matarga/vipr/KiCAD/main/viper.png

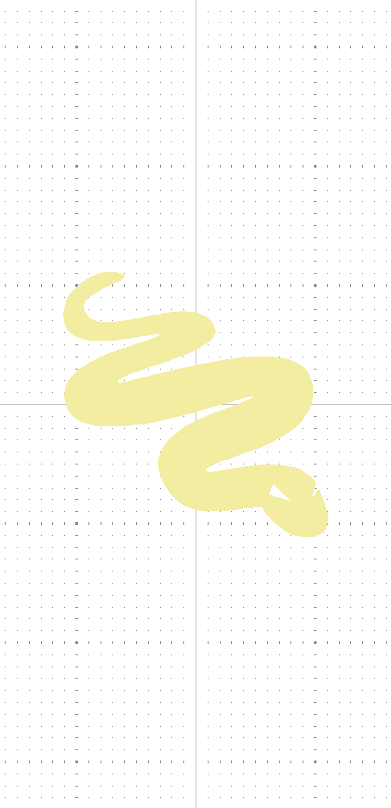
KiCAD/main/viper.png
