matarga/vipr/KiCAD/ref/SX1262 mbed shield with Murata IPD/SX1262MB2IPDDAS_868-915MHz_e588v01a_Murata_BOM.xlsx

Sheet: SX1262MB2IPDDAS
 |  |  | SX1262MB2IPDDAS mbed shield with IPD filter BOM - 868/915MHz |  |  | BOM # V1a
 |  |  |  |  |  | SCH # e588v01a
 |  |  | 2025-11-11 | EMr | Version e588v01a | PCB # e588v01a
RefDes | MPN | Geom | Value | Qty | Description | Manufacturer
U1 | SX1262IMLTRT | VQFN24 4x4mm | SX1262 | 1 | 150MHz to 960MHz Low Power Long Range Transceiver | Semtech
U2 | BGS12WN6 | PG-TSNP-6-10 | - | 1 | Wideband SPDT Diversity Switch with Fast Switching Speed | Infineon
U3 | LFB21892MDZ7F957 | 2.00x1.25mm | 868/915MHz | 1 | 868/915MHz Miniature Impedance-matched Filter for SX1261/62 and LLCC68 optimized for US and EU +22 dBm Operation | Murata
Resistors
R1 | CRCW06030000Z0EAHP | 0603 | 0R | 1 | Thick Film Resistor ±1%, 1/4W | Vishay/Dale
R2 | CRCW06030000Z0EAHP | 0603 | 0R | 1 | Thick Film Resistor ±1%, 1/4W | Vishay/Dale
R3 | CRCW0201100RJNED | 0201 | 100R | 1 | Thick Film Resistor ±5%, 1/20W | Vishay/Dale
R4 | CRCW0201100RJNED | 0201 | 100R | 1 | Thick Film Resistor ±5%, 1/20W | Vishay/Dale
R5 | CRCW02013K30JNED | 0201 | 3.3k | 1 | Thick Film Resistor ±5%, 1/20W | Vishay/Dale
R6 | CRCW02013K30JNED | 0201 | 3.3k | 1 | Thick Film Resistor ±5%, 1/20W | Vishay/Dale
R18 | CRCW04020000Z0ED | 0402 | 0R | 1 | Thick Film Resistor ±1%, 1/16W | Vishay/Dale
R868 | CRCW04020000Z0ED | 0402 | 0R | 1 | Thick Film Resistor ±1%, 1/16W | Vishay/Dale
R915 | CRCW04020000Z0ED | 0402 | 0R | 1 | Thick Film Resistor ±1%, 1/16W | Vishay/Dale
SX1262 | CRCW040210K0FKED | 0402 | 10k | 1 | Thick Film Resistor ±1%, 1/16W | Vishay/Dale
FR1 | CRCW040210K0FKED | 0402 | 10k | 1 | Thick Film Resistor ±1%, 1/16W | Vishay/Dale
XTAL | CRCW04020000Z0ED | 0402 | 0R | 1 | Thick Film Resistor ±1%, 1/16W | Vishay/Dale
Capacitors
C1 | GRM033R61C473KE84D | 0201 | 47nF | 1 | Multilayer ceramic capacitors X5R ±10%, 16V | Murata
C2 | GRM0335C1H470JA01D | 0201 | 47pF | 1 | Multilayer ceramic capacitors COG ±5%, 50V | Murata
C8 | GRM0335C1H390JA01D | 0201 | 39pF | 1 | Multilayer ceramic capacitors COG ±5%, 50V | Murata
C9 |  | 0201 | NC | 0 |  | Murata
C10 |  | 0201 | NC | 0 |  | Murata
C14 | GRM033R71H102KA12D | 0201 | 1nF | 1 | Multilayer ceramic capacitors X7R ±10%, 50V | Murata
C15 | GRM033R71H102KA12D | 0201 | 1nF | 1 | Multilayer ceramic capacitors X7R ±10%, 50V | Murata
C16 | GRM155R61E105KA12D | 0402 | 1uF | 1 | Multilayer ceramic capacitors X5R ±10%, 10V | Murata
C17 | GRM155R61A474KE15D | 0402 | 470nF | 1 | Multilayer ceramic capacitors X5R ±10%, 10V | Murata
C18 | GRM033R61A104KE15D | 0201 | 100nF | 1 | Multilayer ceramic capacitors X5R ±10%, 10V | Murata
C20 | GRM188R61A105KA61D | 0603 | 1uF | 1 | Multilayer ceramic capacitors X5R ±10%, 10V | Murata
C21 | GRM188R61A105KA61D | 0603 | 1uF | 1 | Multilayer ceramic capacitors X5R ±10%, 10V | Murata
C22 | GRM188R61A106KE69D | 0603 | 10uF | 1 | Multilayer ceramic capacitors X5R ±10%, 10V | Murata
C23 | GRM033R61A104KE15D | 0201 | 100nF | 1 | Multilayer ceramic capacitors X5R ±10%, 10V | Murata
Inductors & Ferrites
L1 | LQW15AN47NJ00D | 0402 | 47nH | 1 | Wirewound Inductor ±5% | Murata
L5 | CRCW02010000Z0ED | 0201 | 0R | 1 | Thick Film Resistor ±5%, 1/20W | Murata
L7 | MLZ2012M150W | 0805 | 15uH | 1 | MLZ2012 Multilayer Shielded Inductor ±5% | TDK
or (2nd source) | MLZ1608N100LT000 | 0603 | 10uH | 1 | MLZ1608 Multilayer Shielded Inductor ±20% | TDK
or (2nd source) | MLZ1608N150LT000 | 0603 | 15uH | 1 | MLZ1608 Multilayer Shielded Inductor ±20% | TDK
L8 |  | 0402 | 47nH | 0 |  | Murata
Crystal & TCXO
Q1 | EXS00A-CS06465 | NX2016SA 2.0x1.6mm | 32.000MHz | 1 | Crystal unit NDK; Tol. ±10ppm, Cload=10pF, G-Senstivity=2ppb/G max | NDK
or | FTR5123-A0 | QESM09 2.0x1.6mm | 32.000MHz | - | Crystal unit Rakon; Tol. ±10ppm, Cload=10pF, G-Senstivity=2ppb/G max | Rakon
Connectors and others (or P/N equivalent)
ANT | 142-0701-841 | SMA End Launch | 50 Ohms | 1 | SMA End launch jack receptacle for PCB mount for 1.00mm PCB thickness | Cinch Connectivity Sol Johnson
J1 | 68000-108HLF | Header 1x8 | 8 pins | 1 | 8 Pins - Through hole single row male connector, Bottom side | FCI
J2 | 68000-110HLF | Header 1x10 | 10 pins | 1 | 10 Pins - Through hole single row male connector, Bottom side | FCI
J3 | 68000-108HLF | Header 1x8 | 8 pins | 1 | 8 Pins - Through hole single row male connector, Bottom side | FCI
J4 | 68000-106HLF | Header 1x6 | 6 pins | 1 | 6 Pins - Through hole single row male connector, Bottom side | FCI
ANA_A5_A6 | 1125S-4P | 4-pin - Grove | 4 pins | 0 | 2mm pitch - Grove universal 4-pin connector for sensor (SKU: 320110033), Top side | Shenzhen NS-Tech
DIO_D9_D10 | 1125S-4P | 4-pin - Grove | 4 pins | 0 | 2mm pitch - Grove universal 4-pin connector for sensor (SKU: 320110033), Top side | Shenzhen NS-Tech
I2C | 1125S-4P | 4-pin - Grove | 4 pins | 0 | 2mm pitch - Grove universal 4-pin connector for sensor (SKU: 320110033), Top side | Shenzhen NS-Tech
Additional or optional components
- | BMI-S-209-F | Shield | - | 0 | Standard Surface Mount Shield in two parts with BMI-S-209-C cover (optional) | Laird Technologies
Remark: components not listed in the BOM or 0 quantity, are not populated on the module.

Sheet: Release
 |  | SX1262MB2IPDDAS mbed shield with IPD filter BOM - 868/915MHz |  |  |  | BOM # V1a
 |  |  |  |  |  | SCH # e588v01a
 |  | 2025-11-11 | EMr | Version e588v01a |  | PCB # e588v01a
Release history
Version | Change notes |  |  |  | By
pcb_e588v01a | Module based on PCB_E499V01B with IPD filter. |  |  |  | EMr
 | Update BOM with P/N - 18.05.2020 |  |  |  | EMr
 | Update BOM @868/915MHz only with P/N - 22.02.2022 |  |  |  | EMr
 | Replacement of U2 RF switch with BGS12WN6 - 03.03.2025 |  |  |  | EMr
 | IPD Murata P/N updated |  |  |  | EMr
