matarga/vipr/KiCAD/main/step/901-10040-1/3D/901-10040-1.stp

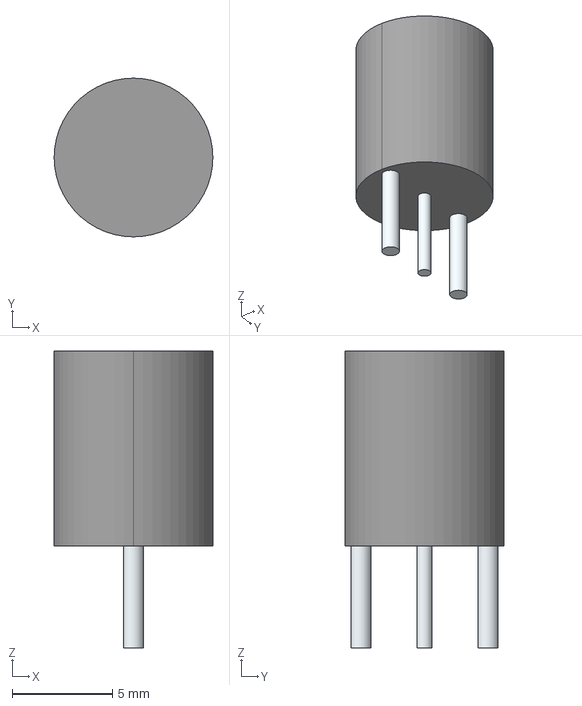
[picture p5: CAD file, 2026-09-06]
KiCAD/main/step/901-10040-1/3D/901-10040-1.stp
7.92 x 7.92 x 14.8 mm
Leads x 3
