matarga/vipr/KiCAD/main/step/FT231XQ-R/3D/FT231XQ-R.stp

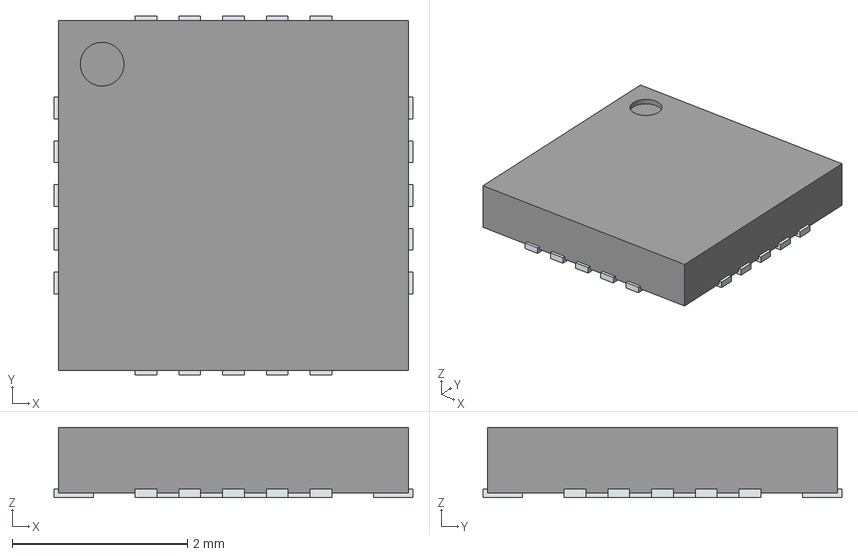
[picture p6: CAD file, 2026-09-06]
KiCAD/main/step/FT231XQ-R/3D/FT231XQ-R.stp
4.10 x 4.10 x 0.8 mm
ThermalPin
PinsArrayLR
PinsArrayTB
