matarga/vipr/KiCAD/main/step/TP4056-42-ESOP8/3D/TP4056-42-ESOP8.stp

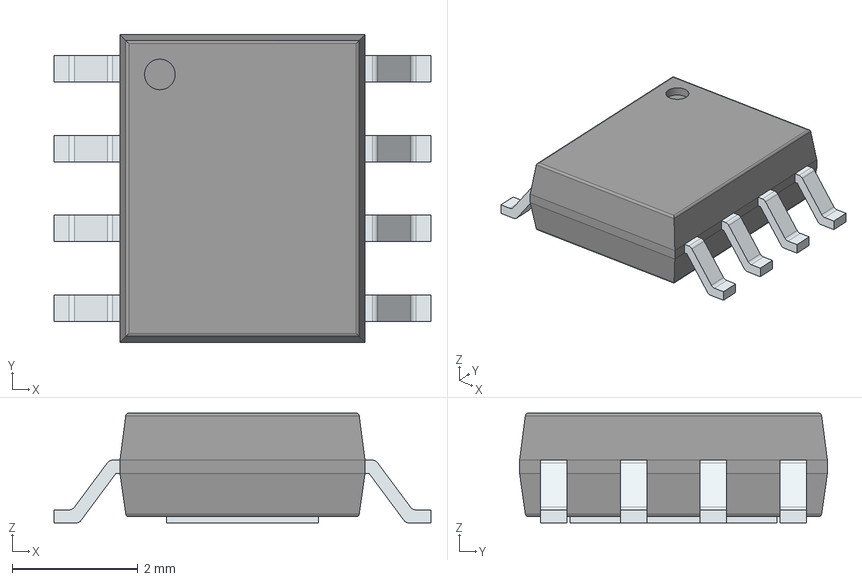
[picture p7: CAD file, 2026-09-06]
KiCAD/main/step/TP4056-42-ESOP8/3D/TP4056-42-ESOP8.stp
6.00 x 4.90 x 1.75 mm
PinsArrayLR
ThermalPad
