matarga/vipr/KiCAD/main/finals/rev 2.0/main.step

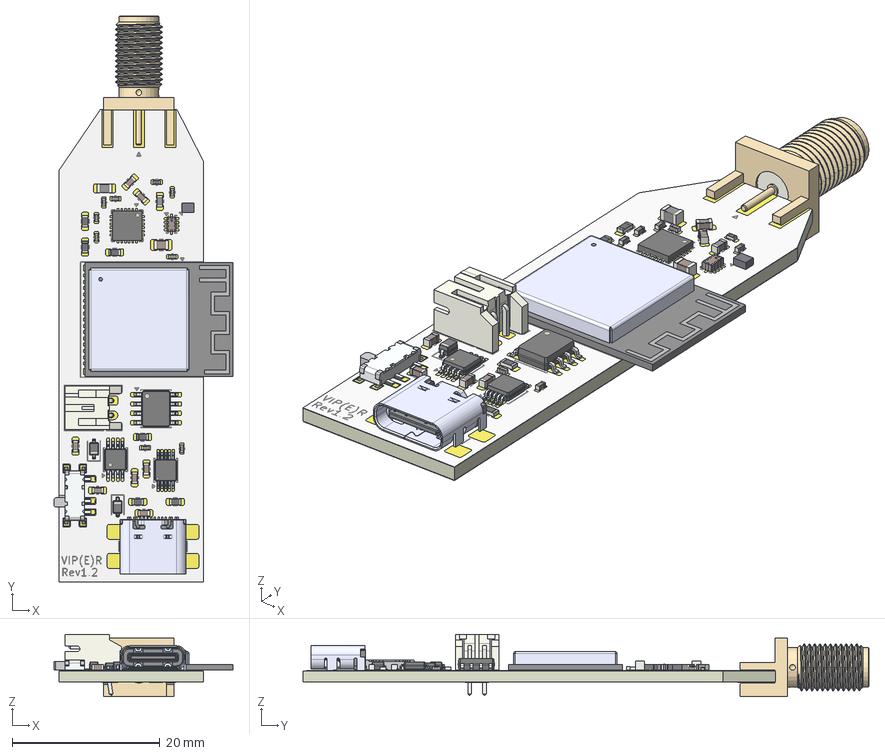
[picture p8: CAD file, 2026-09-06, an earlier design]
KiCAD/main/finals/rev 2.0/main.step
24.2 x 76.6 x 8.43 mm
C_0603_1608Metric x 7
C_0402_1005Metric x 8
R_0603_1608Metric x 6
ESP32-S2-MINI-1
QFN-24-1EP_4x4mm_Pitch0.5mm
D_SOD-323 x 2
MSOP-8_3x3mm_P0.65mm
L_0805_2012Metric
X-axis x 3
XY-plane x 3
Sketch
Sketch001
LinearPattern
SOIC-8-1EP_3.9x4.9mm_P1.27mm_EP2.41x3.81mm
SMA_Amphenol_132289_EdgeMount
SSSS810701
USB4105GFA_USB4105GFA
JST_S2B_PH_K
4d195fed-b8b3-11ee-a4d2-001e64e93a09_part
4d195fee-b8b3-11ee-a4d2-001e64e93a09_part
4d195fef-b8b3-11ee-a4d2-001e64e93a09_part
C_0805_2012Metric
R_0402_1005Metric
MSOP-10_3x3mm_P0.5mm
L_0603_1608Metric
main-unsaved-export-qwL5oJ_copper
main-unsaved-export-qwL5oJ_silkscreen x 2
main-unsaved-export-qwL5oJ_soldermask x 2
main-unsaved-export-qwL5oJ_PCB
