matarga/vipr/(list of files, cad)

Other CAD files:
KiCAD/main/step/901-10040-1/Allegro/901100401.psm
KiCAD/main/step/901-10040-1/DEHDL/901_10040_1/chips/chips.prt
KiCAD/main/step/BGS12WN6E6327XTSA1/Allegro/bgs12wn6e6327xtsa1.psm
KiCAD/main/step/BGS12WN6E6327XTSA1/DEHDL/bgs12wn6e6327xtsa1/chips/chips.prt
KiCAD/main/step/ESP32-MINI-1-H4/Allegro/esp32mini1h4.psm
KiCAD/main/step/ESP32-MINI-1-H4/DEHDL/esp32_mini_1_h4/chips/chips.prt
KiCAD/main/step/FT231XQ-R/Allegro/qfn50p400x400x80-21n.psm
KiCAD/main/step/FT231XQ-R/DEHDL/ft231xq_r/chips/chips.prt
KiCAD/main/step/SX1262IMLTRT/Allegro/qfn50p400x400x100-25n-d.psm
KiCAD/main/step/SX1262IMLTRT/DEHDL/sx1262imltrt/chips/chips.prt
KiCAD/main/step/TLV75533PDRVR/Allegro/son65p200x200x80-7n.psm
KiCAD/main/step/TLV75533PDRVR/DEHDL/tlv75533pdrvr/chips/chips.prt
KiCAD/main/step/TP4056-42-ESOP8/DEHDL/tp4056_42_esop8/chips/chips.prt
