matarga/vipr/KiCAD/ref/SX1262 mbed shield with Murata IPD/SX1262MB2IPDDAS_e588v01a_Murata_IPD_schematic_layout.pdf

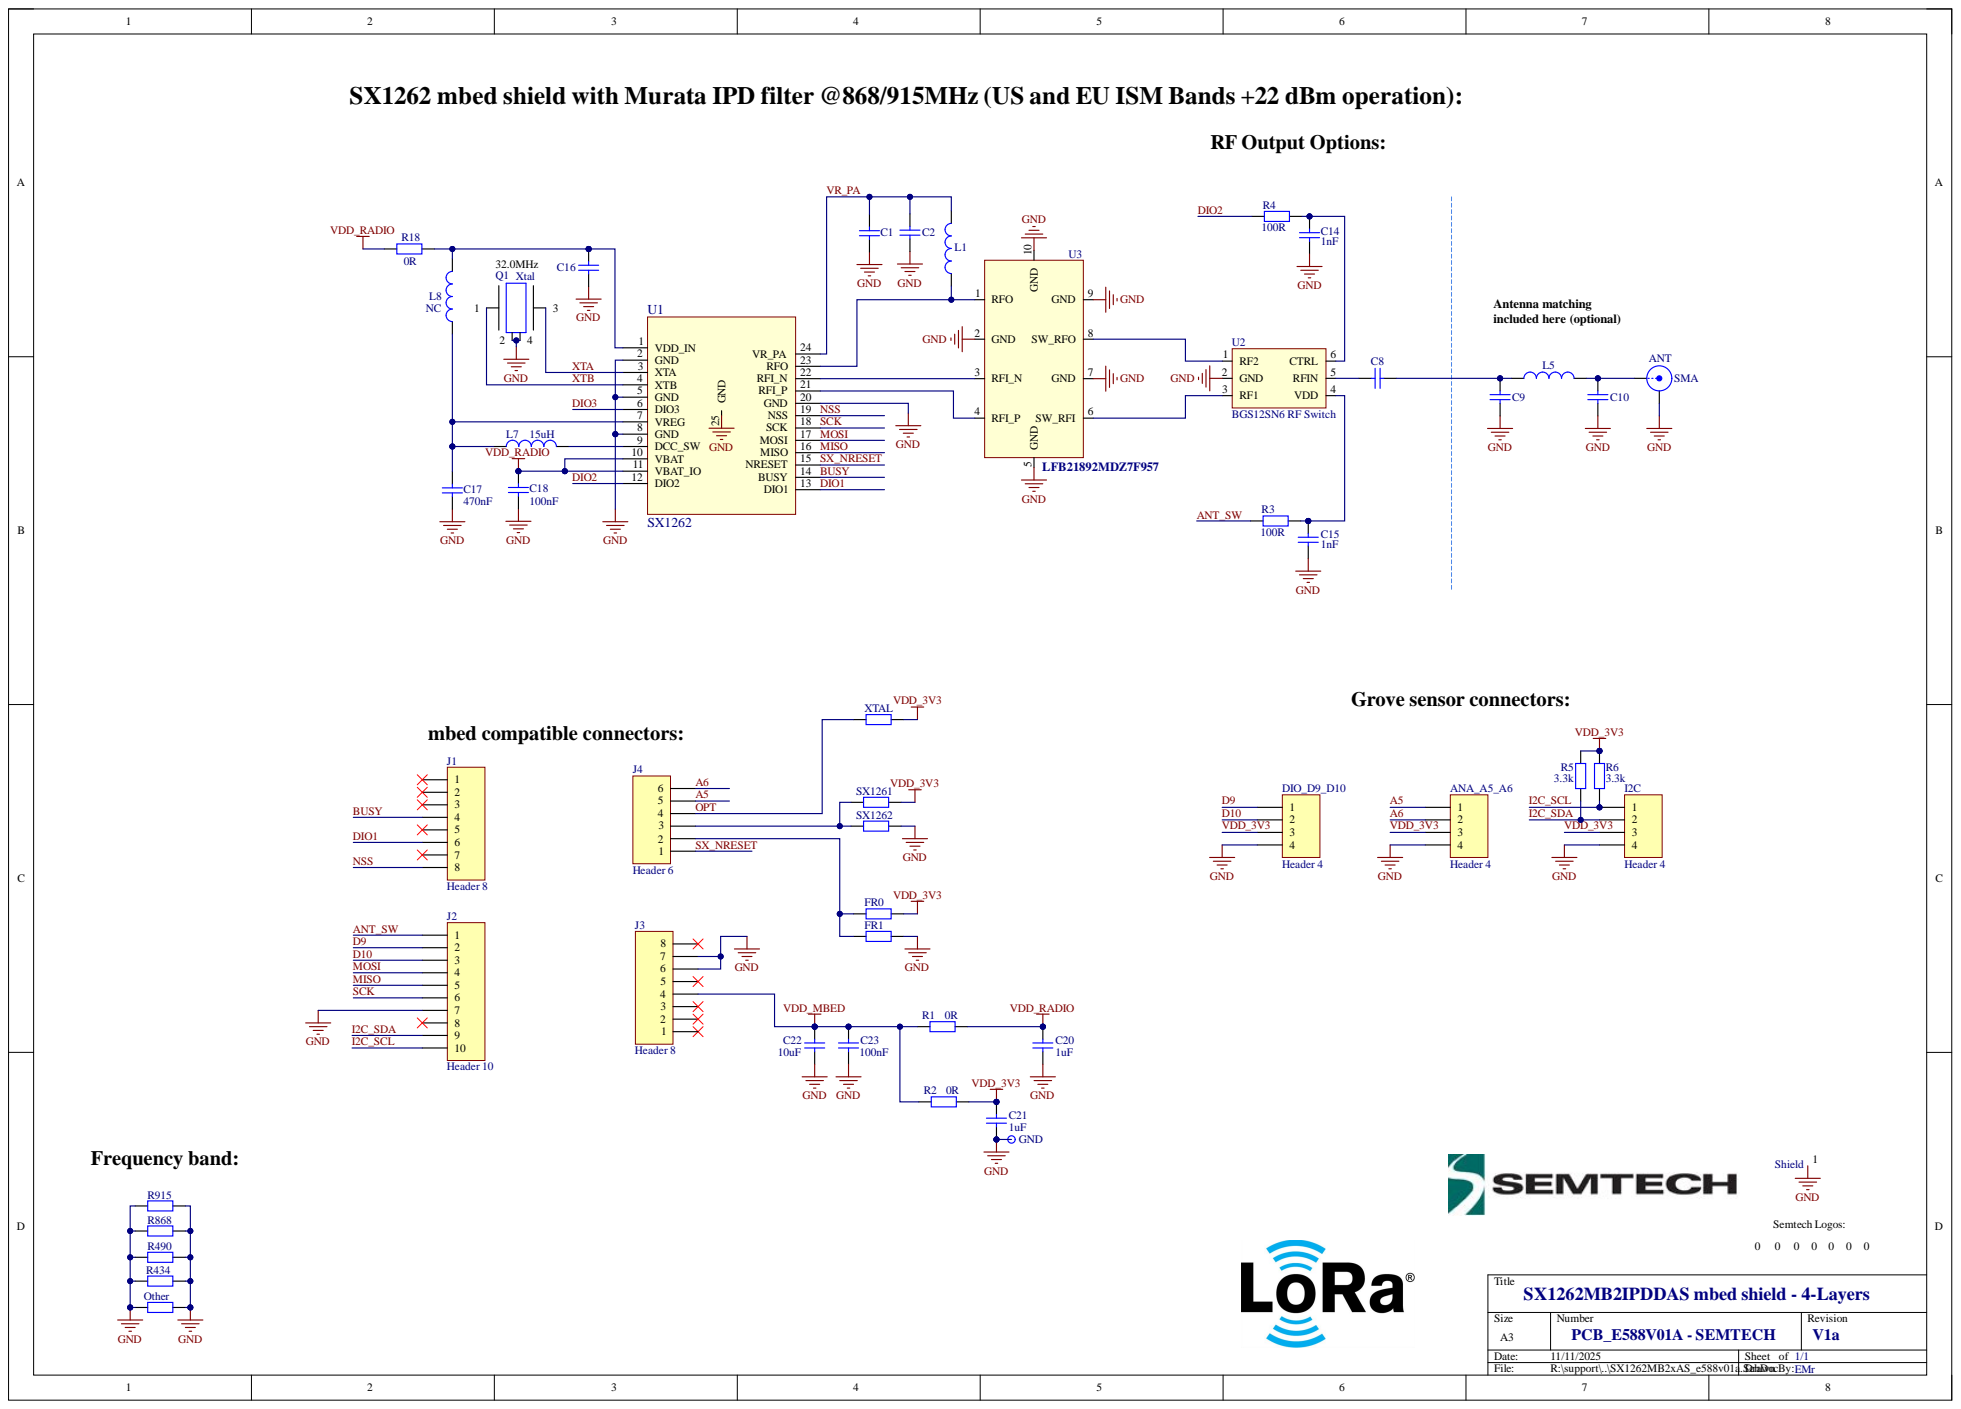
[picture p12: page 1]

SX1262 mbed shield with Murata IPD filter @868/915MHz (US and EU ISM Bands +22 dBm operation):

GND

DIO2 12 | BUSY

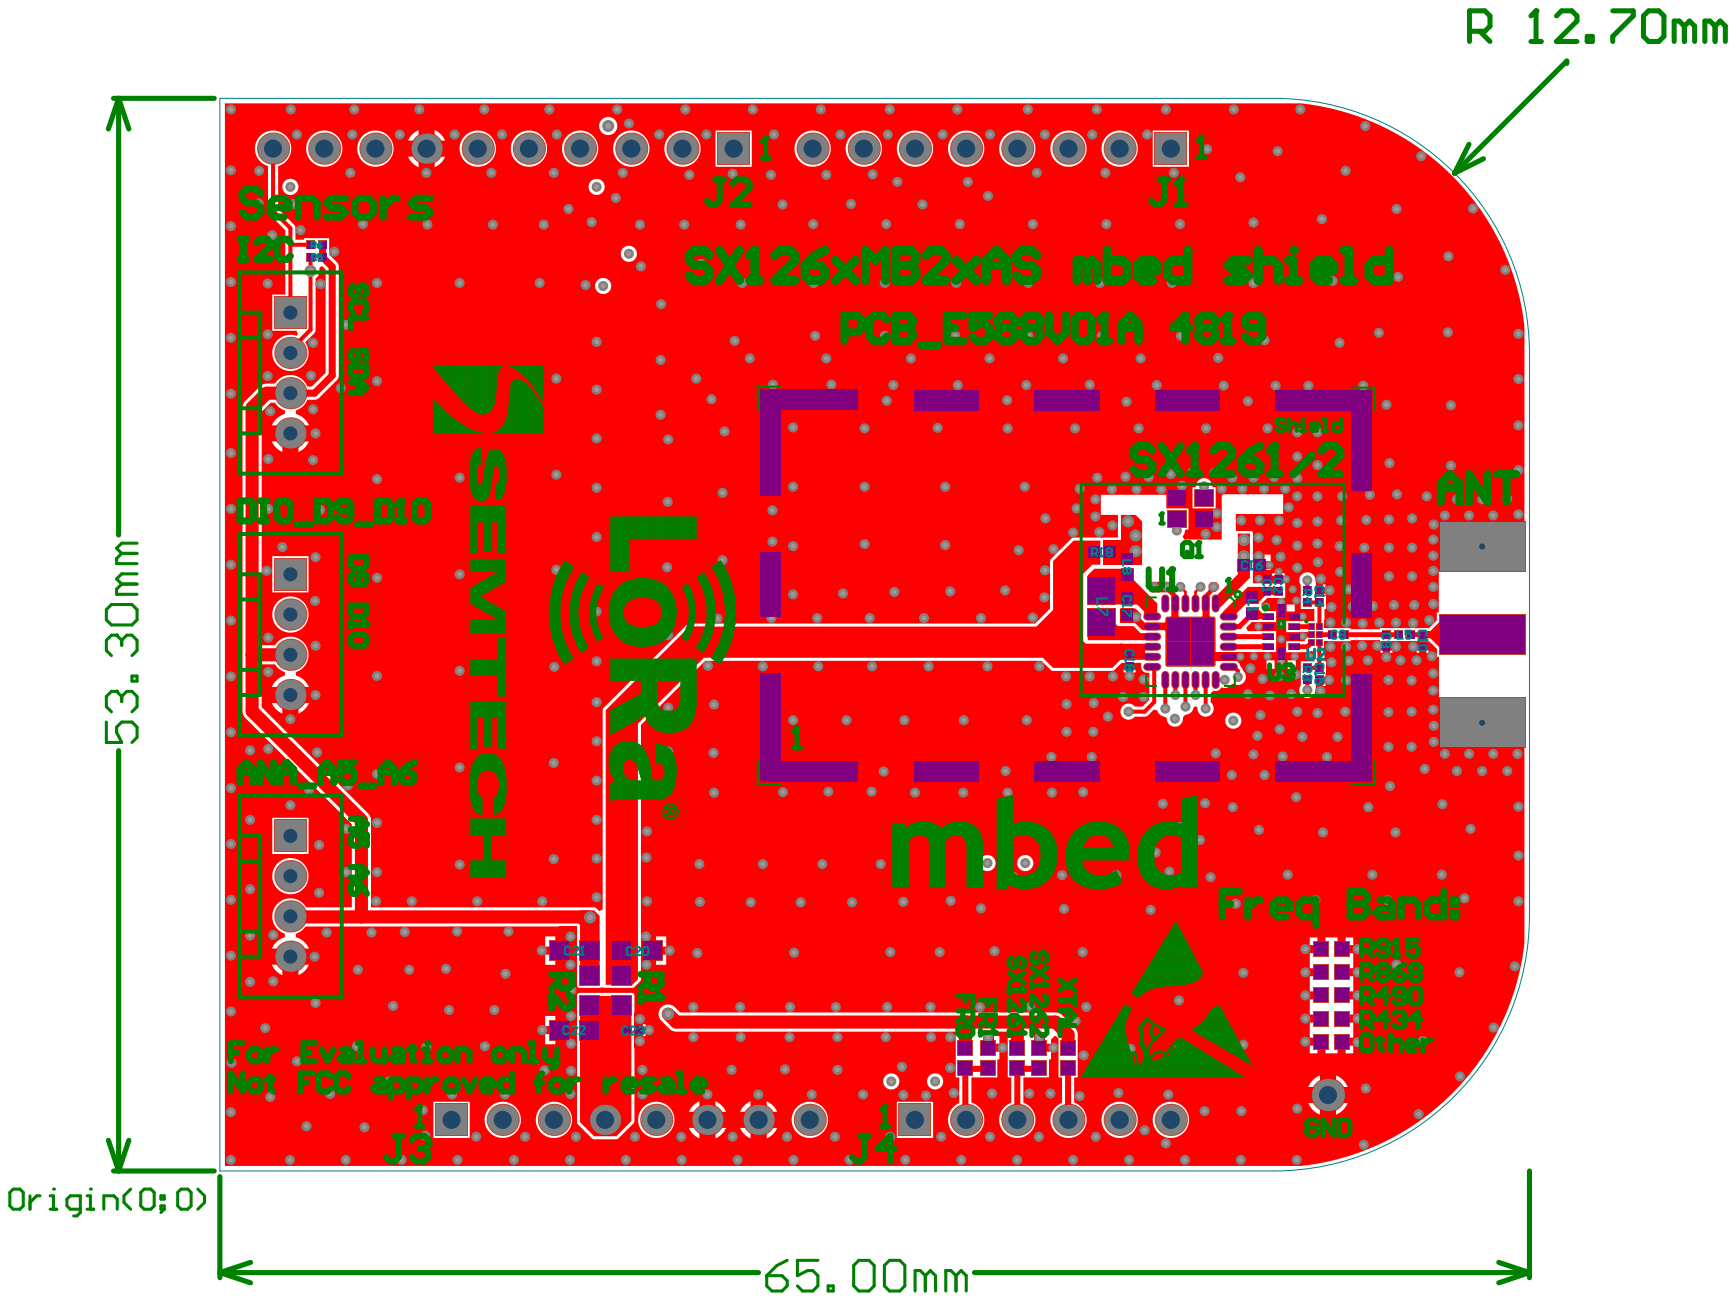
[picture p13: page 2]

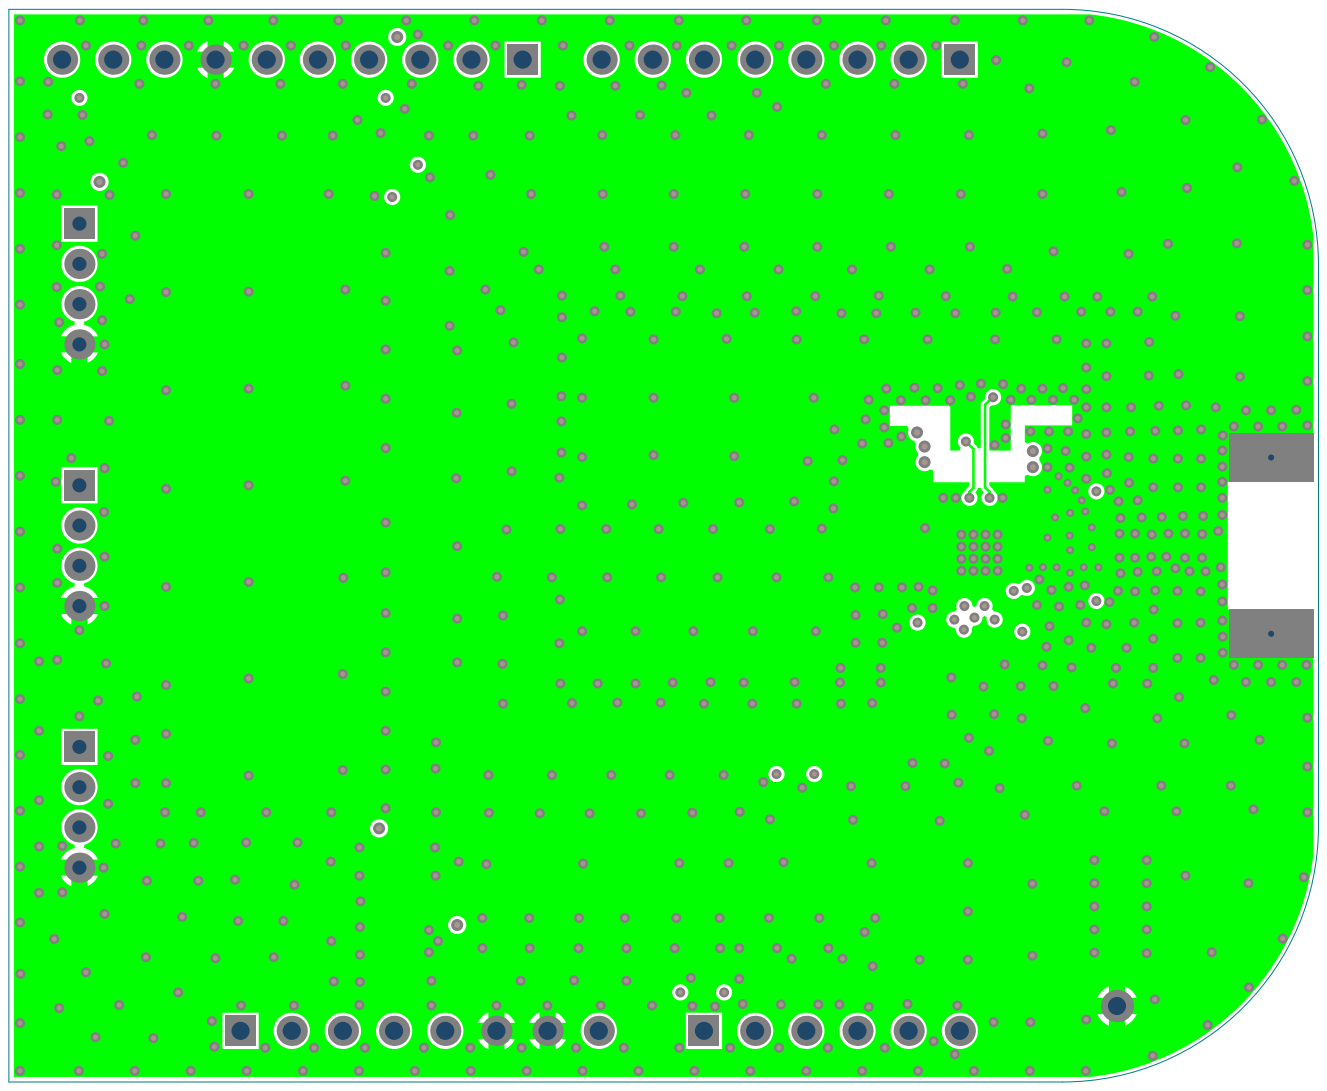
[picture p14: page 3]

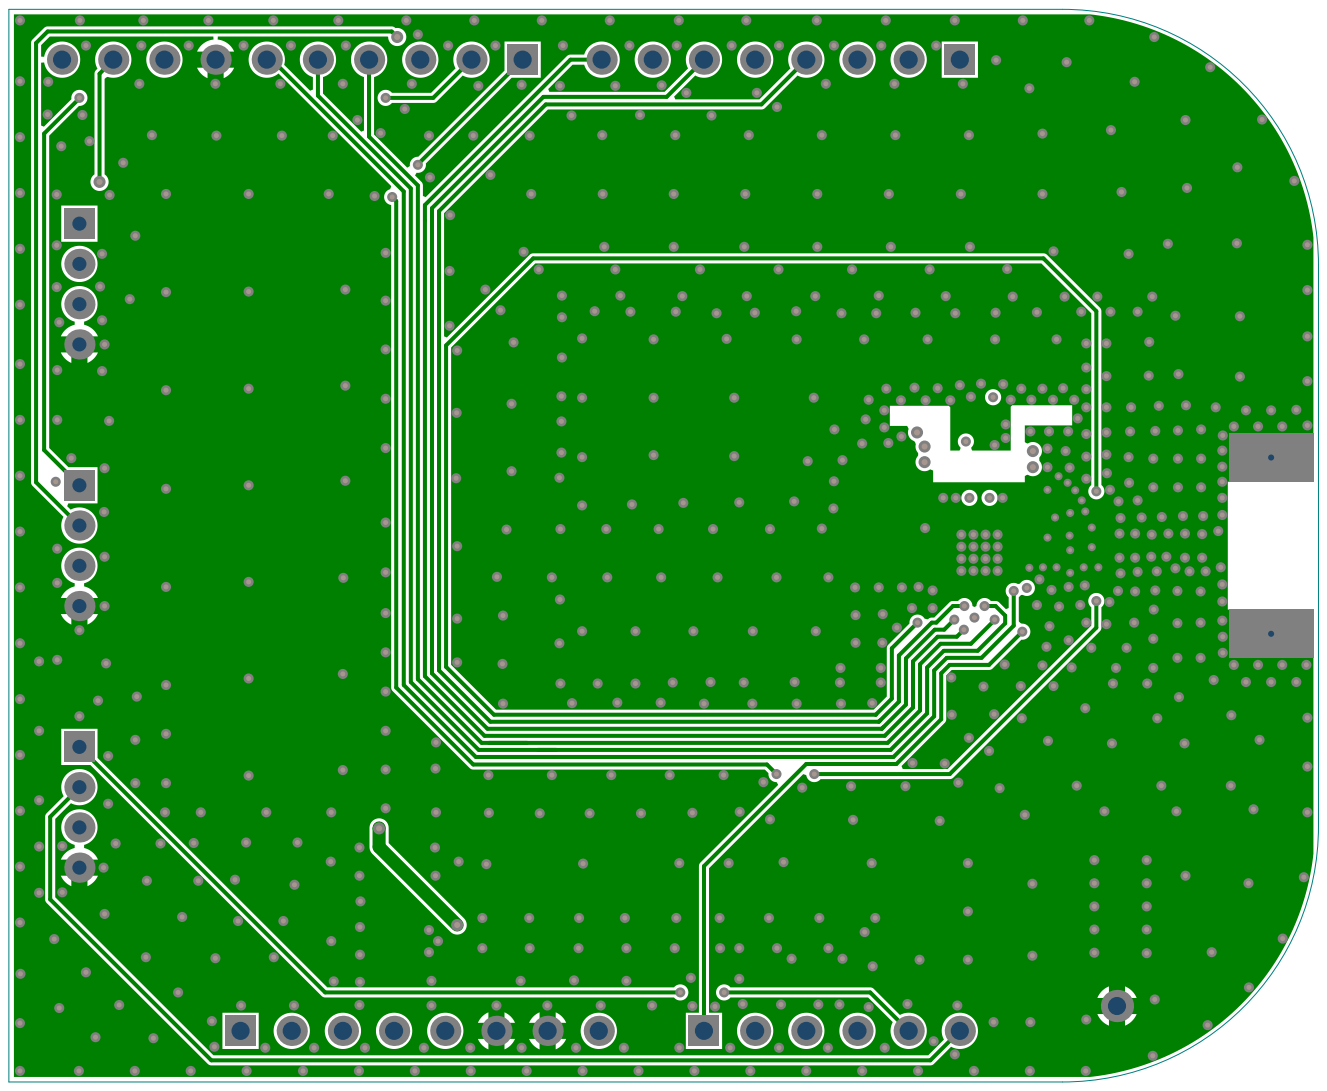
[picture p15: page 4]

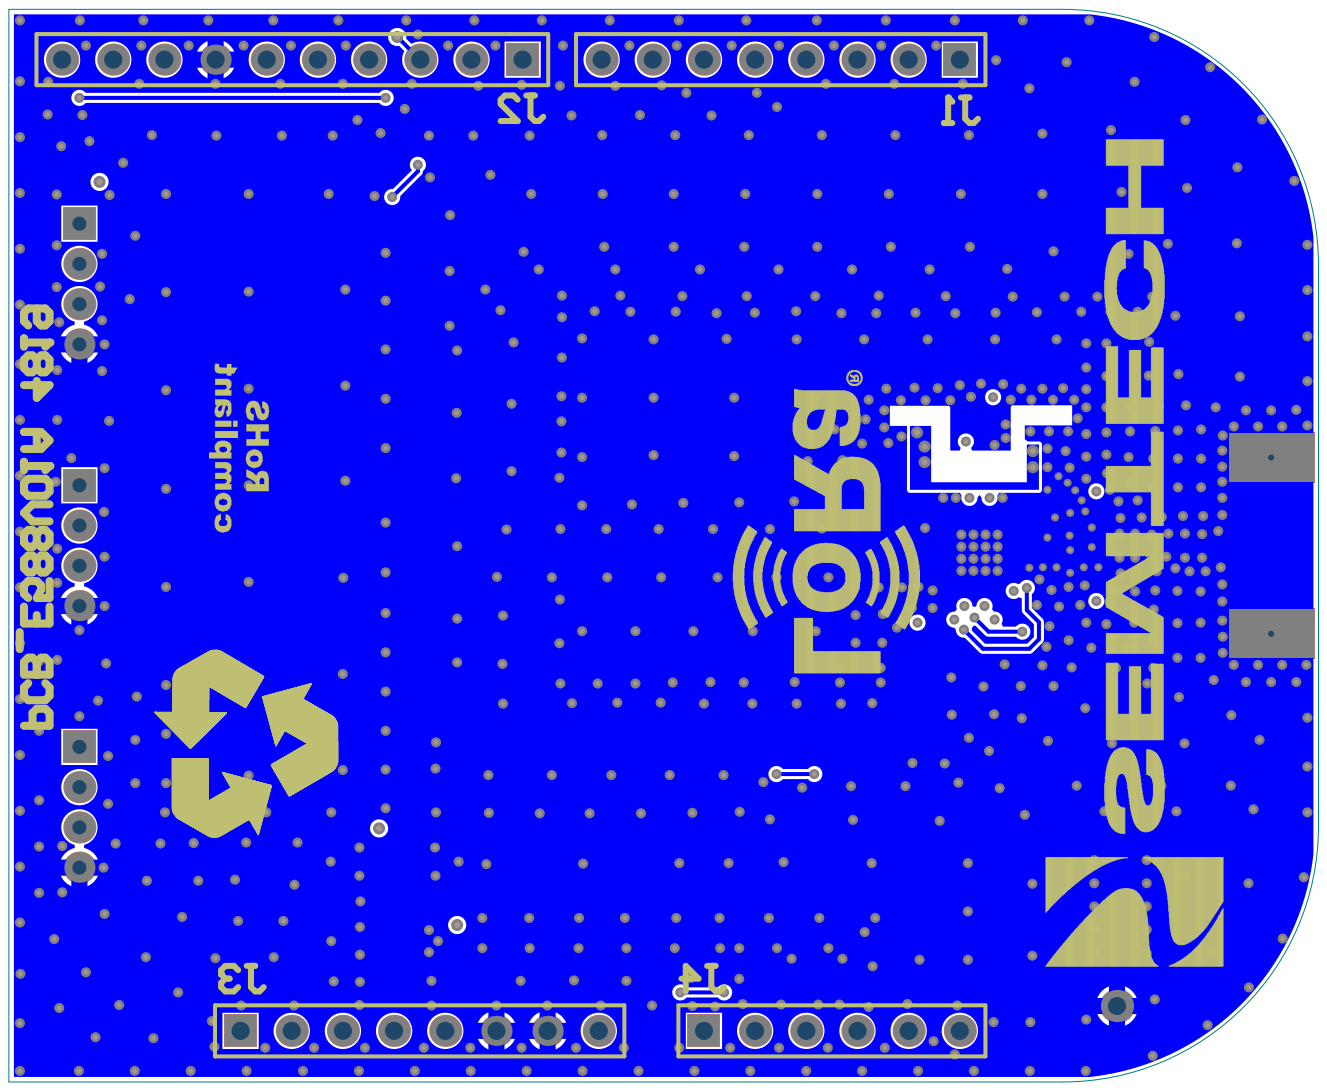
[picture p16: page 5]
