matarga/vipr/KiCAD/ref/SX1262 mbed shield with Murata IPD/SX126xMB2IPDDAS_868-915MHz_e588v01a_assembly.pdf

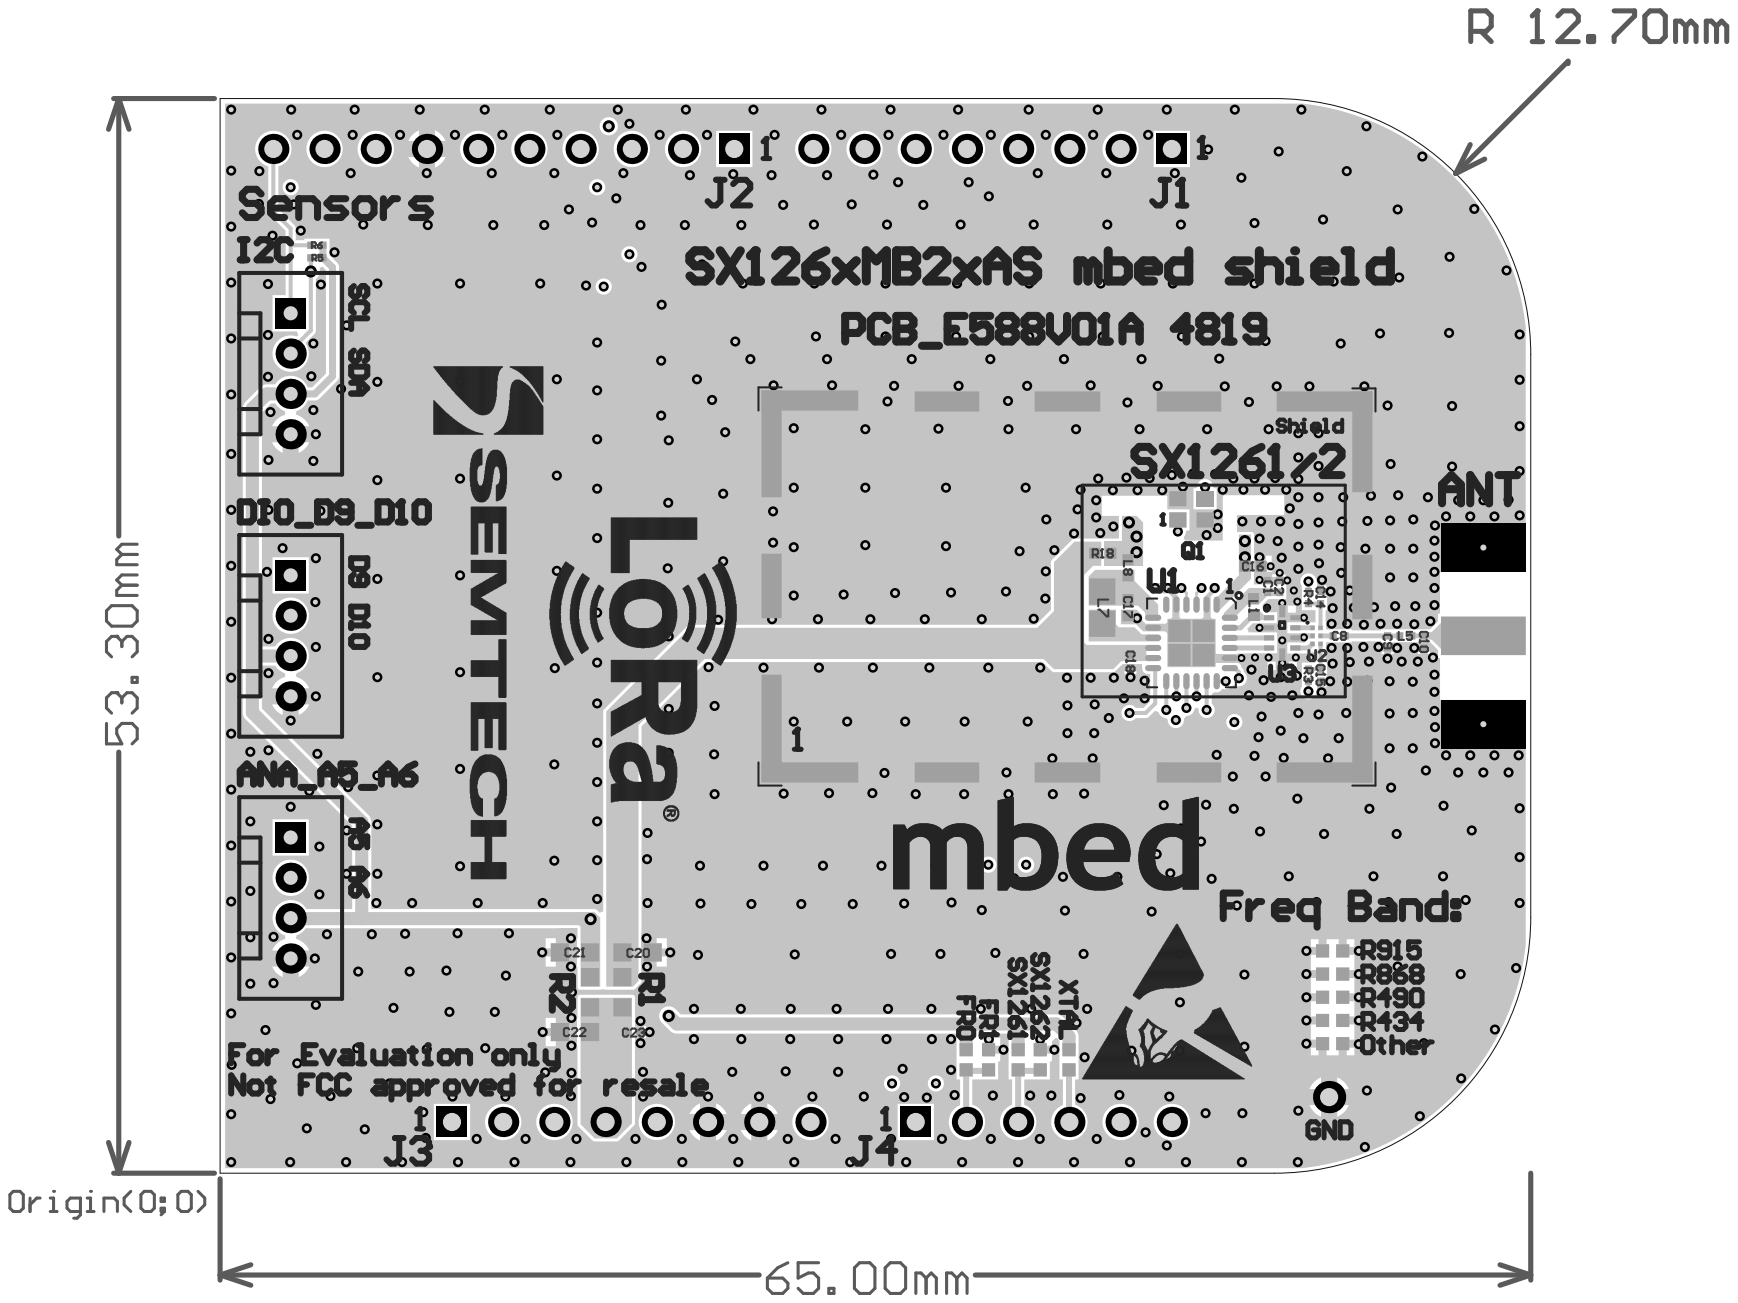
[picture p17: page 1]

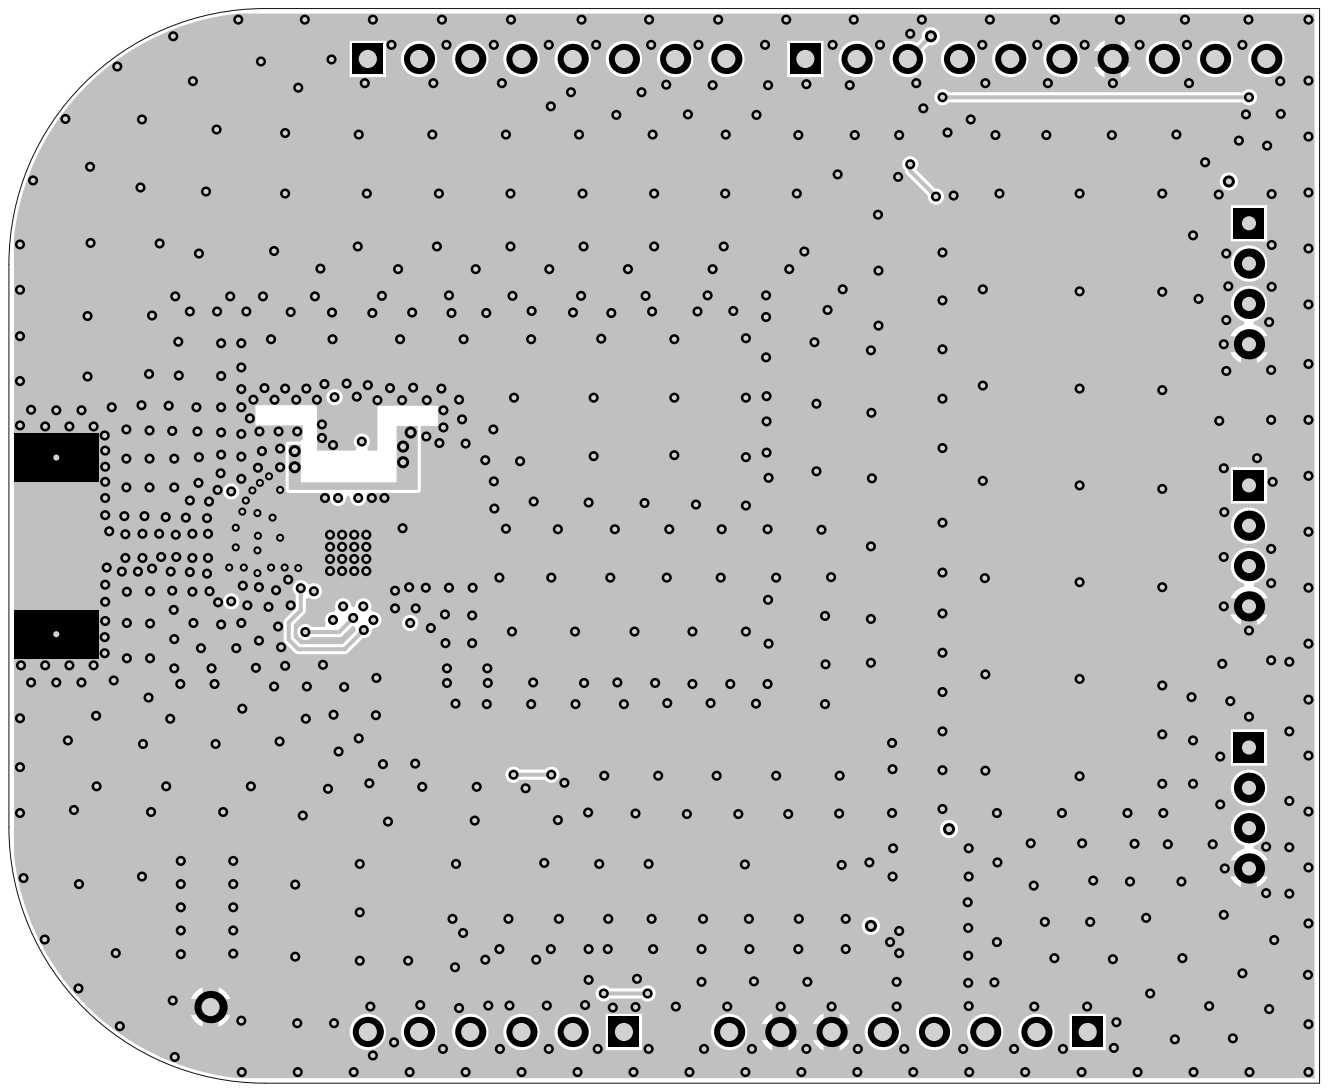
[picture p18: page 2]
