matarga/vipr/(list of files, drawings)

Other design files:
KiCAD/main/step/901-10040-1/Altium/901-10040-1.SchLib
KiCAD/main/step/901-10040-1/Altium/901100401.PcbLib
KiCAD/main/step/BGS12WN6E6327XTSA1/Altium/BGS12WN6E6327XTSA1.PcbLib
KiCAD/main/step/BGS12WN6E6327XTSA1/Altium/BGS12WN6E6327XTSA1.SchLib
KiCAD/main/step/ESP32-MINI-1-H4/Altium/ESP32-MINI-1-H4.SchLib
KiCAD/main/step/ESP32-MINI-1-H4/Altium/ESP32MINI1H4.PcbLib
KiCAD/main/step/FT231XQ-R/Altium/FT231XQ-R.SchLib
KiCAD/main/step/FT231XQ-R/Altium/QFN50P400X400X80-21N.PcbLib
KiCAD/main/step/TLV75533PDRVR/Altium/SON65P200X200X80-7N.PcbLib
KiCAD/main/step/TLV75533PDRVR/Altium/TLV75533PDRVR.SchLib
KiCAD/main/step/TP4056-42-ESOP8/Altium/SOIC127P600X175-9N.PcbLib
KiCAD/main/step/TP4056-42-ESOP8/Altium/TP4056-42-ESOP8.SchLib
KiCAD/ref/SX1262 mbed shield with Murata IPD/altium/SX126xMB2xAS_e588v01a.PcbDoc
KiCAD/ref/SX1262 mbed shield with Murata IPD/altium/SX126xMB2xAS_e588v01a.PcbLib
KiCAD/ref/SX1262 mbed shield with Murata IPD/altium/SX126xMB2xAS_e588v01a.PrjPCB
KiCAD/ref/SX1262 mbed shield with Murata IPD/altium/SX126xMB2xAS_e588v01a.SchDoc
KiCAD/ref/SX1262 mbed shield with Murata IPD/altium/SX126xMB2xAS_e588v01a.SchLib
