matarga/vipr/KiCAD/main/finals/rev 2.1/main.kicad_pcb

## KiCad design KiCAD/main/finals/rev 2.1/main.kicad_pcb (2026-10-18)

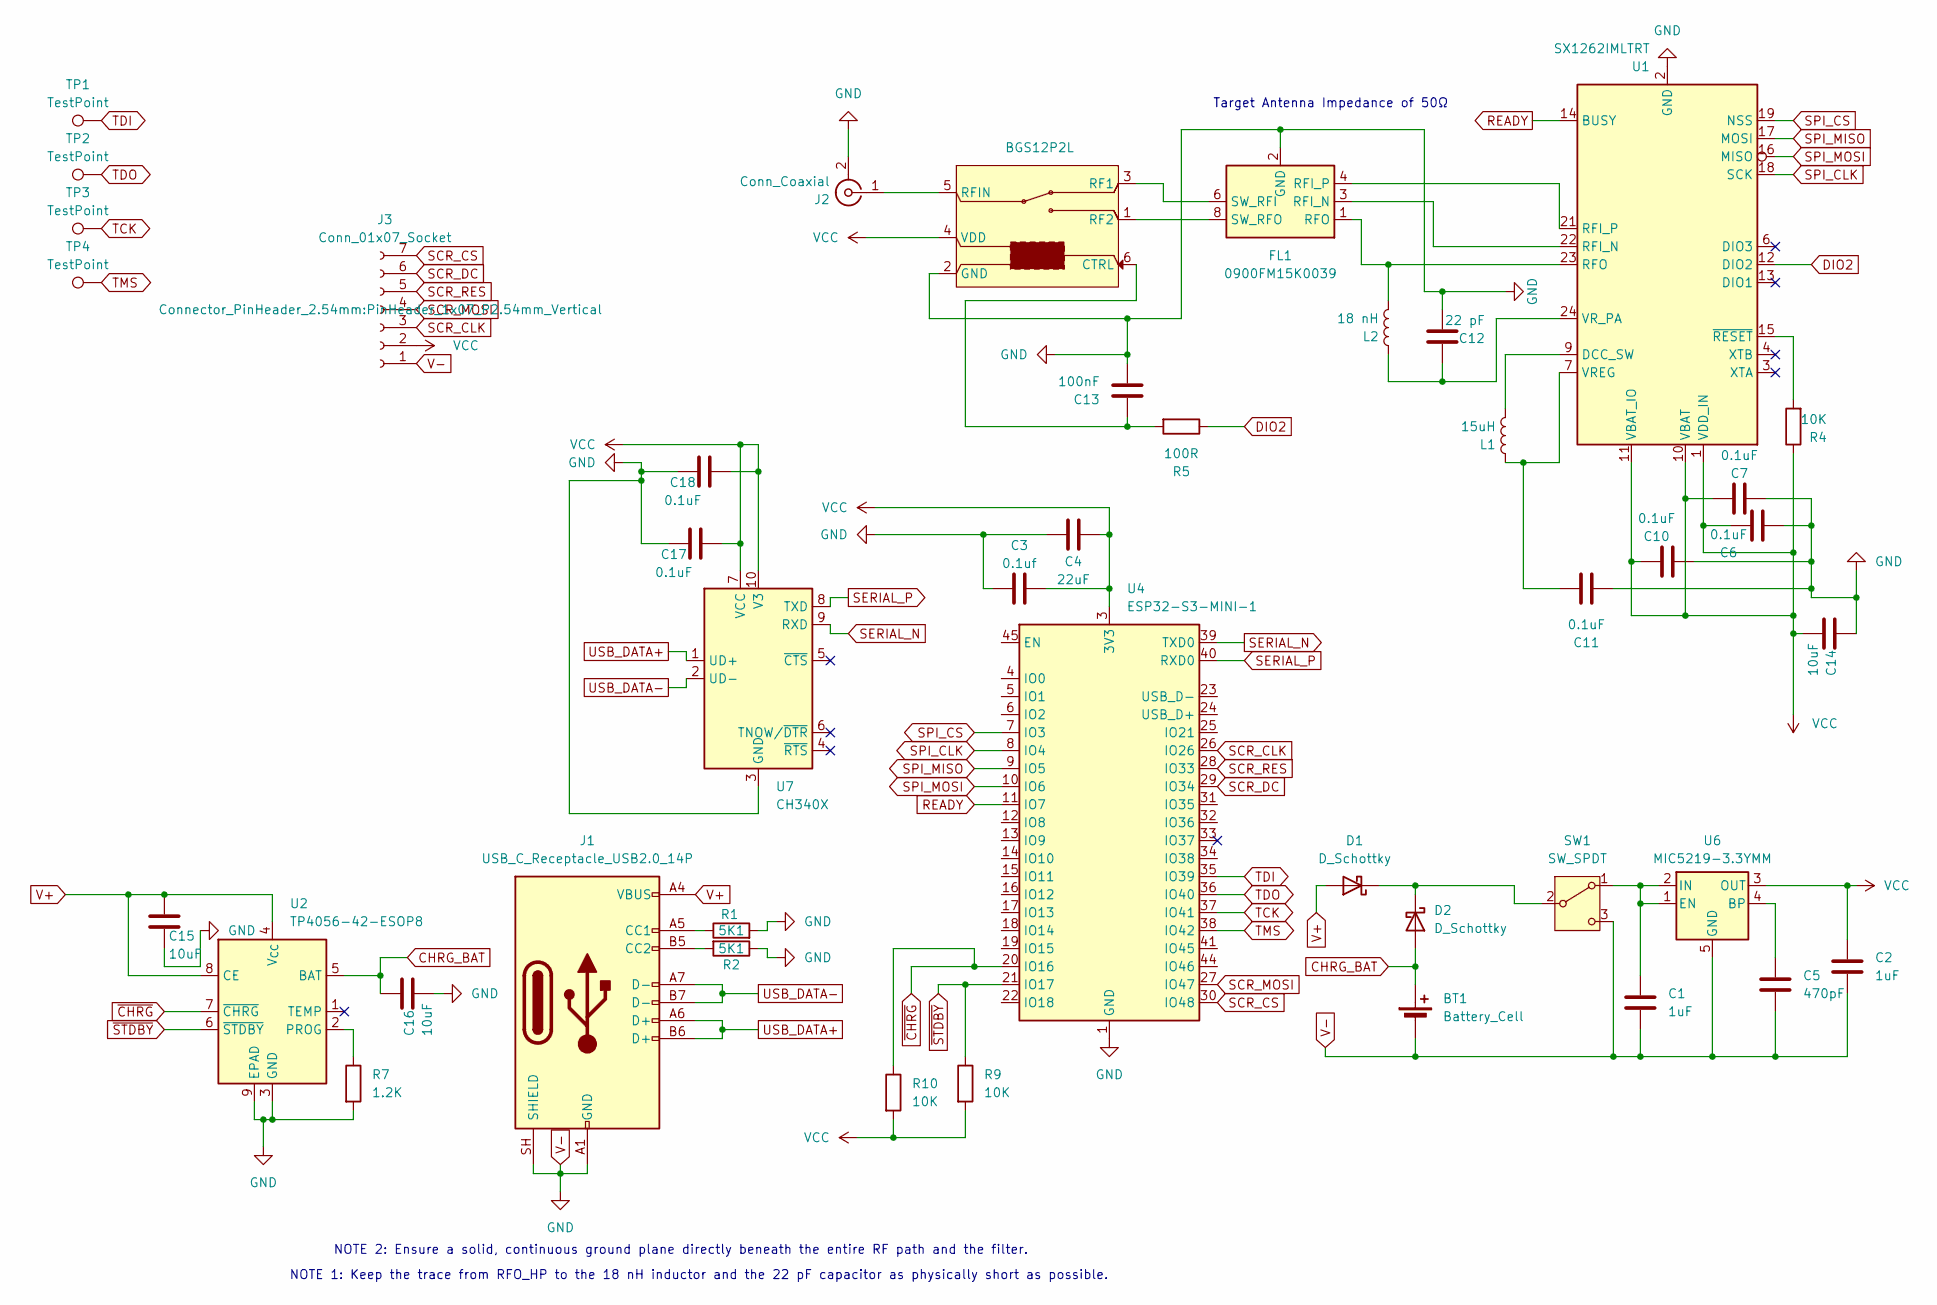
[picture p19: schematic main.kicad_sch]

Parts:
BT1: Battery_Cell; JST_PH_S2B-PH-K_1x02_P2.00mm_Horizontal; LCSC Part # C265094
C1, C2: 1uF; C_0603_1608Metric; LCSC Part # C15849
C3: 0.1uf; C_0402_1005Metric; LCSC Part # C1525
C4: 22uF; C_0805_2012Metric; LCSC Part # C45783
C5: 470pF; C_0603_1608Metric; LCSC Part # C1620
C6, C7, C10, C11, C17, C18: 0.1uF; C_0402_1005Metric; LCSC Part # C1525
C12: 22 pF; C_0603_1608Metric; LCSC Part # C1653
C13: 100nF; C_0402_1005Metric; LCSC Part # C1525
C14, C15, C16: 10uF; C_0603_1608Metric; LCSC Part # C19702
D1, D2: D_Schottky; D_SOD-323; LCSC Part # C191023
FL1: 0900FM15K0039; Balun_Johanson_0900FM15K0039
J1: USB_C_Receptacle_USB2.0_14P; USB_C_Receptacle_GCT_USB4110; LCSC Part # C2765186
J2: Conn_Coaxial; SMA_Amphenol_132289_EdgeMount; LCSC Part # C3039673
J3: Conn_01x07_Socket; PinHeader_1x07_P2.54mm_Vertical
L1: 15uH; L_0805_2012Metric; LCSC Part # C383402
L2: 18 nH; L_0603_1608Metric; LCSC Part # C19721138
R1, R2: 5K1; R_0603_1608Metric; LCSC Part # C23186
R4, R9, R10: 10K; R_0603_1608Metric; LCSC Part # C25804
R5: 100R; R_0402_1005Metric; LCSC Part # C25076
R7: 1.2K; R_0603_1608Metric; LCSC Part # C22765
SW1: SW_SPDT; SSSS810701; LCSC Part # C97433
TP1, TP2, TP3, TP4: TestPoint; TestPoint_Pad_1.5x1.5mm
U1: SX1262IMLTRT; QFN-24-1EP_4x4mm_P0.5mm_EP2.6x2.6mm; LCSC Part # C191341
U2: TP4056-42-ESOP8; SOIC-8-1EP_3.9x4.9mm_P1.27mm_EP2.41x3.3mm_ThermalVias; LCSC Part # C16581
U3: BGS12P2L; Infineon_PG-TSNP-6-10_0.7x1.1mm_0.7x1.1mm_P0.4mm; LCSC Part # C3312945
U4: ESP32-S3-MINI-1; ESP32-S2-MINI-1
U6: MIC5219-3.3YMM; MSOP-8_3x3mm_P0.65mm; LCSC Part # C628154
U7: CH340X; MSOP-10_3x3mm_P0.5mm; LCSC Part # C3035748

Connections:
CHRG_BAT: BT1.1 (+), C16.2, D2.2 (A), U2.5 (BAT)
DIO2: R5.1, U1.12 (DIO2)
unnamed: D1.1 (K), D2.1 (K), SW1.2 (B)
unnamed: FL1.3 (RFI_N), U1.22 (RFI_N)
unnamed: FL1.4 (RFI_P), U1.21 (RFI_P)
unnamed: FL1.1 (RFO), L2.2, U1.23 (RFO)
unnamed: FL1.6 (SW_RFI), U3.3 (RF1)
unnamed: FL1.8 (SW_RFO), U3.1 (RF2)
unnamed: J1.A5 (CC1), R1.1
unnamed: J1.B5 (CC2), R2.2
unnamed: J2.1 (In), U3.5 (RFIN)
unnamed: C1.2, SW1.1 (A), U6.1 (EN), U6.2 (IN)
unnamed: L1.2, U1.9 (DCC_SW)
unnamed: C11.2, L1.1, U1.7 (VREG)
unnamed: C12.1, L2.1, U1.24 (VR_PA)
unnamed: R4.2, U1.15 (~RESET)
unnamed: R7.1, U2.2 (PROG)
unnamed: C13.1, R5.2, U3.6 (CTRL)
unnamed: C5.1, U6.4 (BP)
READY: U1.14 (BUSY), U4.11 (IO7)
SCR_CLK: J3.3, U4.26 (IO26)
SCR_CS: J3.7, U4.30 (IO48)
SCR_DC: J3.6, U4.29 (IO34)
SCR_MOSI: J3.4, U4.27 (IO47)
SCR_RES: J3.5, U4.28 (IO33)
SERIAL_N: U4.39 (TXD0), U7.9 (RXD)
SERIAL_P: U4.40 (RXD0), U7.8 (TXD)
SPI_CLK: U1.18 (SCK), U4.8 (IO4)
SPI_CS: U1.19 (NSS), U4.7 (IO3)
SPI_MISO: U1.17 (MOSI), U4.9 (IO5)
SPI_MOSI: U1.16 (MISO), U4.10 (IO6)
TCK: TP3.1 (1_1), U4.37 (IO41)
TDI: TP1.1 (1_1), U4.35 (IO39)
TDO: TP2.1 (1_1), U4.36 (IO40)
TMS: TP4.1 (1_1), U4.38 (IO42)
USB_DATA+: J1.A6 (D+), J1.B6 (D+), U7.1 (UD+)
USB_DATA-: J1.A7 (D-), J1.B7 (D-), U7.2 (UD-)
V+: C15.1, D1.2 (A), J1.A4 (VBUS), J1.A9 (VBUS), J1.B4 (VBUS), J1.B9 (VBUS), U2.4 (V_{CC}), U2.8 (CE)
V-: BT1.2 (-), C1.1, C2.1, C3.1, C4.1, C5.2, C6.2, C7.2, C10.2, C11.1, C12.2, C13.2, C14.1, C15.2, C16.1, C17.1, C18.1, FL1.2 (GND), FL1.5 (GND), FL1.7 (GND), FL1.9 (GND), FL1.10 (GND), J1.A1 (GND), J1.A12 (GND), J1.B1 (GND), J1.B12 (GND), J1.SH (SHIELD), J2.2 (Ext), J3.1, R1.2, R2.1, R7.2, SW1.3 (C), U1.2 (GND), U1.5 (GND), U1.8 (GND), U1.20 (GND), U1.25 (GND), U2.3 (GND), U2.9 (EPAD), U3.2 (GND), U4.1 (GND), U4.2 (GND), U4.42 (GND), U4.43 (GND), U4.46 (GND), U4.47 (GND), U4.48 (GND), U4.49 (GND), U4.50 (GND), U4.51 (GND), U4.52 (GND), U4.53 (GND), U4.54 (GND), U4.55 (GND), U4.56 (GND), U4.57 (GND), U4.58 (GND), U4.59 (GND), U4.60 (GND), U4.61 (GND), U4.62 (GND), U4.63 (GND), U4.64 (GND), U4.65 (GND), U6.5 (GND), U6.6 (GND), U6.7 (GND), U6.8 (GND), U7.3 (GND)
VCC: C2.2, C3.2, C4.2, C6.1, C7.1, C10.1, C14.2, C17.2, C18.2, J3.2, R4.1, R9.2, R10.2, U1.1 (VDD_IN), U1.10 (VBAT), U1.11 (VBAT_IO), U3.4 (VDD), U4.3 (3V3), U6.3 (OUT), U7.7 (VCC), U7.10 (V3)
~CHRG: R10.1, U2.7 (~CHRG), U4.20 (IO16)
~STDBY: R9.1, U2.6 (~STDBY), U4.21 (IO17)

Notes on the sheet:
NOTE 1: Keep the trace from RFO_HP to the 18 nH inductor and the 22 pF capacitor as physically short as possible.
NOTE 2: Ensure a solid, continuous ground plane directly beneath the entire RF path and the filter.
Target Antenna Impedance of 50Ω

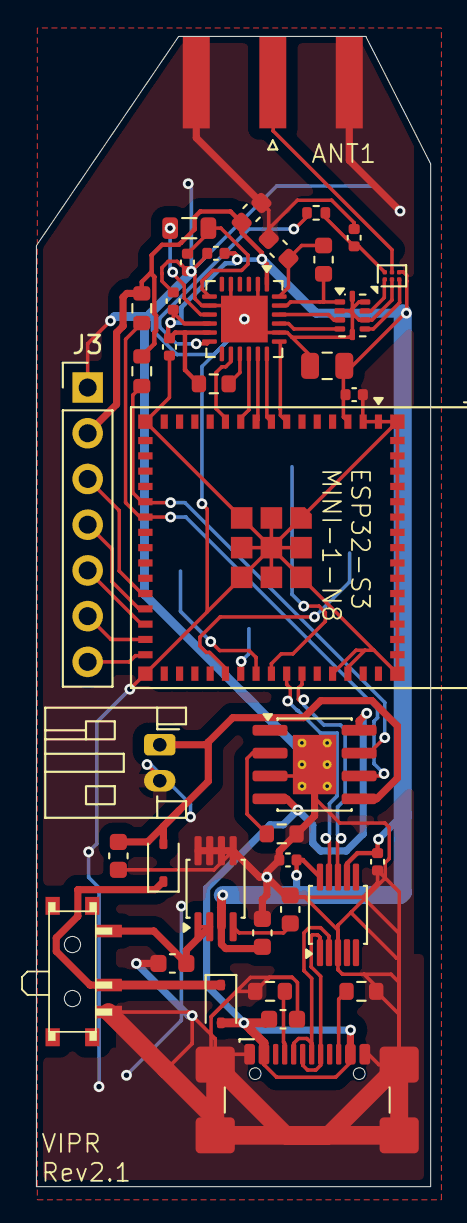
[picture p20: board KiCAD/main/finals/rev 2.1/main.kicad_pcb from above]

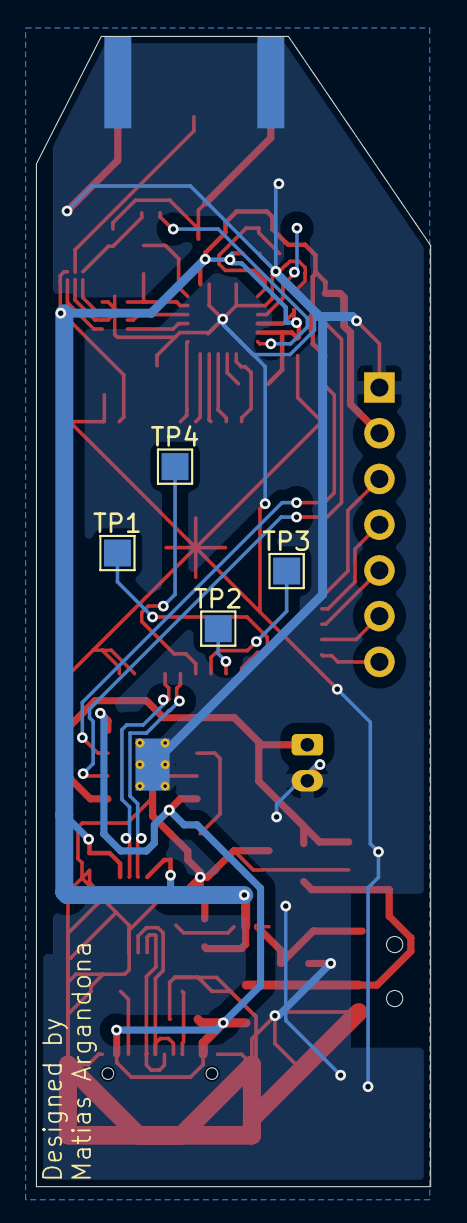
[picture p21: board KiCAD/main/finals/rev 2.1/main.kicad_pcb from below]

Board: 2 copper layers, 21.9 x 63.9 mm, 43 parts (4 on the bottom side), 42 nets.
