matarga/vipr/KiCAD/main/finals/rev2.1/main.kicad_pcb

## KiCad design KiCAD/main/finals/rev2.1/main.kicad_pcb (2026-10-18)

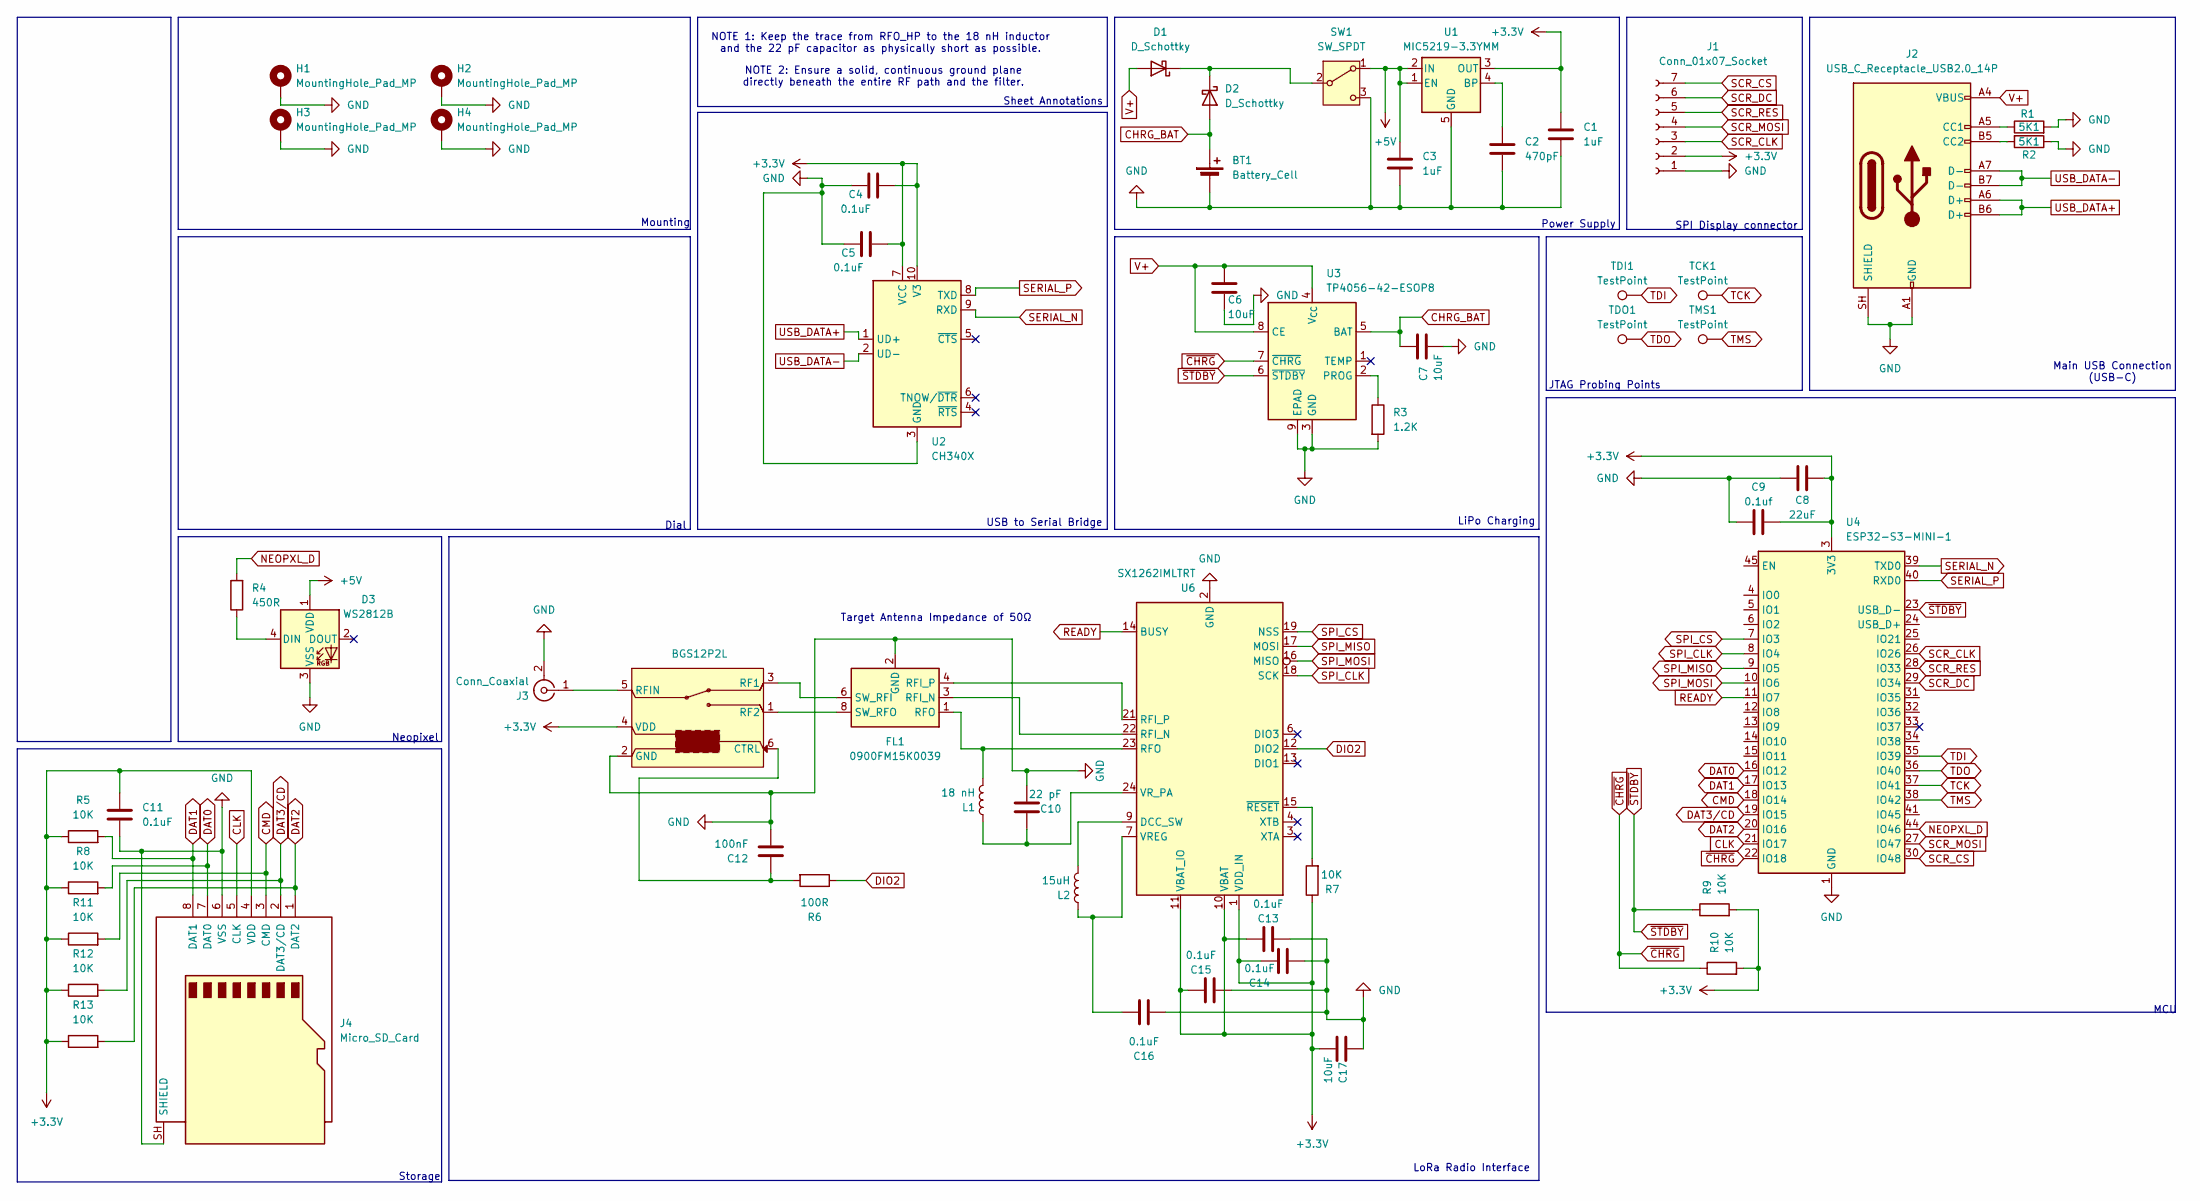
[picture p22: schematic main.kicad_sch]

Parts:
BT1: Battery_Cell; JST_PH_S2B-PH-K_1x02_P2.00mm_Horizontal; LCSC Part # C265094
C1, C3: 1uF; C_0603_1608Metric; LCSC Part # C77386
C2: 470pF; C_0603_1608Metric; LCSC Part # C1620
C4, C5, C11, C13, C14, C15, C16: 0.1uF; C_0402_1005Metric; LCSC Part # C1525
C6, C7, C17: 10uF; C_0603_1608Metric; LCSC Part # C19702
C8: 22uF; C_0805_2012Metric; LCSC Part # C45783
C9: 0.1uf; C_0402_1005Metric; LCSC Part # C1525
C10: 22 pF; C_0603_1608Metric; LCSC Part # C1653
C12: 100nF; C_0402_1005Metric; LCSC Part # C1525
D1, D2: D_Schottky; D_SOD-323; LCSC Part # C191023
D3: WS2812B; LED_WS2812B_PLCC4_5.0x5.0mm_P3.2mm; LCSC Part # C114586
FL1: 0900FM15K0039; Balun_Johanson_0900FM15K0039; LCSC Part # C7434807
H1, H2, H3, H4: MountingHole_Pad_MP; MountingHole_2.5mm_Pad_TopBottom
J1: Conn_01x07_Socket; PinHeader_1x07_P2.54mm_Vertical
J2: USB_C_Receptacle_USB2.0_14P; USB_C_Receptacle_GCT_USB4110; LCSC Part # C2765186
J3: Conn_Coaxial; SMA_Amphenol_132289_EdgeMount; LCSC Part # C3039673
J4: Micro_SD_Card; SIM-SMD_8P-1040310811; LCSC Part # C585350
L1: 18 nH; L_0603_1608Metric; LCSC Part # C19721138
L2: 15uH; L_0805_2012Metric; LCSC Part # C383402
R1, R2: 5K1; R_0603_1608Metric; LCSC Part # C23186
R3: 1.2K; R_0603_1608Metric; LCSC Part # C22765
R4: 450R; R_0402_1005Metric; LCSC Part # C186129
R5, R7, R8, R9, R10, R11, R12, R13: 10K; R_0603_1608Metric; LCSC Part # C2961367
R6: 100R; R_0402_1005Metric; LCSC Part # C25076
SW1: SW_SPDT; SSSS810701; LCSC Part # C97433
TCK1: TestPoint; TestPoint_Pad_1.5x1.5mm
TDI1: TestPoint; TestPoint_Pad_1.5x1.5mm
TDO1: TestPoint; TestPoint_Pad_1.5x1.5mm
TMS1: TestPoint; TestPoint_Pad_1.5x1.5mm
U1: MIC5219-3.3YMM; MSOP-8_3x3mm_P0.65mm; LCSC Part # C628154
U2: CH340X; MSOP-10_3x3mm_P0.5mm; LCSC Part # C3035748
U3: TP4056-42-ESOP8; SOIC-8-1EP_3.9x4.9mm_P1.27mm_EP2.41x3.3mm_ThermalVias; LCSC Part # C16581
U4: ESP32-S3-MINI-1; ESP32-S2-MINI-1; LCSC Part # C2913206
U5: BGS12P2L; Infineon_PG-TSNP-6-10_0.7x1.1mm_0.7x1.1mm_P0.4mm; LCSC Part # C3312945
U6: SX1262IMLTRT; QFN-24-1EP_4x4mm_P0.5mm_EP2.6x2.6mm; LCSC Part # C191341

Connections:
+5V: C3.2, D3.1 (VDD), SW1.1 (A), U1.1 (EN), U1.2 (IN)
CHRG_BAT: BT1.1 (+), C7.2, D2.2 (A), U3.5 (BAT)
CLK: J4.5 (CLK), U4.21 (IO17)
CMD: J4.3 (CMD), R11.2, U4.18 (IO14)
DAT0: J4.7 (DAT0), R8.2, U4.16 (IO12)
DAT1: J4.8 (DAT1), R5.2, U4.17 (IO13)
DAT2: J4.1 (DAT2), R13.2, U4.20 (IO16)
DAT3/CD: J4.2 (DAT3/CD), R12.2, U4.19 (IO15)
DIO2: R6.1, U6.12 (DIO2)
GND: BT1.2 (-), C1.1, C2.2, C3.1, C4.1, C5.1, C6.2, C7.1, C8.1, C9.1, C10.2, C11.1, C12.2, C13.2, C14.2, C15.2, C16.1, C17.1, D3.3 (VSS), FL1.2 (GND), FL1.5 (GND), FL1.7 (GND), FL1.9 (GND), FL1.10 (GND), H1.MP, H2.MP, H3.MP, H4.MP, J1.1, J2.A1 (GND), J2.A12 (GND), J2.B1 (GND), J2.B12 (GND), J2.SH (SHIELD), J3.2 (Ext), J4.6 (VSS), J4.SH (SHIELD), R1.2, R2.1, R3.2, SW1.3 (C), U1.5 (GND), U1.6 (GND), U1.7 (GND), U1.8 (GND), U2.3 (GND), U3.3 (GND), U3.9 (EPAD), U4.1 (GND), U4.2 (GND), U4.42 (GND), U4.43 (GND), U4.46 (GND), U4.47 (GND), U4.48 (GND), U4.49 (GND), U4.50 (GND), U4.51 (GND), U4.52 (GND), U4.53 (GND), U4.54 (GND), U4.55 (GND), U4.56 (GND), U4.57 (GND), U4.58 (GND), U4.59 (GND), U4.60 (GND), U4.61 (GND), U4.62 (GND), U4.63 (GND), U4.64 (GND), U4.65 (GND), U5.2 (GND), U6.2 (GND), U6.5 (GND), U6.8 (GND), U6.20 (GND), U6.25 (GND)
NEOPXL_D: R4.2, U4.44 (IO46)
unnamed: D1.1 (K), D2.1 (K), SW1.2 (B)
unnamed: D3.4 (DIN), R4.1
unnamed: FL1.3 (RFI_N), U6.22 (RFI_N)
unnamed: FL1.4 (RFI_P), U6.21 (RFI_P)
unnamed: FL1.1 (RFO), L1.2, U6.23 (RFO)
unnamed: FL1.6 (SW_RFI), U5.3 (RF1)
unnamed: FL1.8 (SW_RFO), U5.1 (RF2)
unnamed: J2.A5 (CC1), R1.1
unnamed: J2.B5 (CC2), R2.2
unnamed: J3.1 (In), U5.5 (RFIN)
unnamed: C2.1, U1.4 (BP)
unnamed: R3.1, U3.2 (PROG)
unnamed: C12.1, R6.2, U5.6 (CTRL)
unnamed: L2.2, U6.9 (DCC_SW)
unnamed: C16.2, L2.1, U6.7 (VREG)
unnamed: C10.1, L1.1, U6.24 (VR_PA)
unnamed: R7.2, U6.15 (~RESET)
READY: U4.11 (IO7), U6.14 (BUSY)
SCR_CLK: J1.3, U4.26 (IO26)
SCR_CS: J1.7, U4.30 (IO48)
SCR_DC: J1.6, U4.29 (IO34)
SCR_MOSI: J1.4, U4.27 (IO47)
SCR_RES: J1.5, U4.28 (IO33)
SERIAL_N: U2.9 (RXD), U4.39 (TXD0)
SERIAL_P: U2.8 (TXD), U4.40 (RXD0)
SPI_CLK: U4.8 (IO4), U6.18 (SCK)
SPI_CS: U4.7 (IO3), U6.19 (NSS)
SPI_MISO: U4.9 (IO5), U6.17 (MOSI)
SPI_MOSI: U4.10 (IO6), U6.16 (MISO)
TCK: TCK1.1 (1_1), U4.37 (IO41)
TDI: TDI1.1 (1_1), U4.35 (IO39)
TDO: TDO1.1 (1_1), U4.36 (IO40)
TMS: TMS1.1 (1_1), U4.38 (IO42)
USB_DATA+: J2.A6 (D+), J2.B6 (D+), U2.1 (UD+)
USB_DATA-: J2.A7 (D-), J2.B7 (D-), U2.2 (UD-)
V+: C6.1, D1.2 (A), J2.A4 (VBUS), J2.A9 (VBUS), J2.B4 (VBUS), J2.B9 (VBUS), U3.4 (V_{CC}), U3.8 (CE)
~CHRG: R10.1, U3.7 (~CHRG), U4.22 (IO18); also elsewhere on the board
~STDBY: R9.1, U3.6 (~STDBY), U4.23 (USB_D-); also elsewhere on the board

Notes on the sheet:
Storage
Sheet Annotations
NOTE 1: Keep the trace from RFO_HP to the 18 nH inductor and the 22 pF capacitor as physically short as possible.
NOTE 2: Ensure a solid, continuous ground plane directly beneath the entire RF path and the filter.
SPI Display connector
MCU
LiPo Charging
Main USB Connection (USB-C)
JTAG Probing Points
LoRa Radio Interface
Dial
Target Antenna Impedance of 50Ω
Power Supply
Neopixel
Mounting
USB to Serial Bridge

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
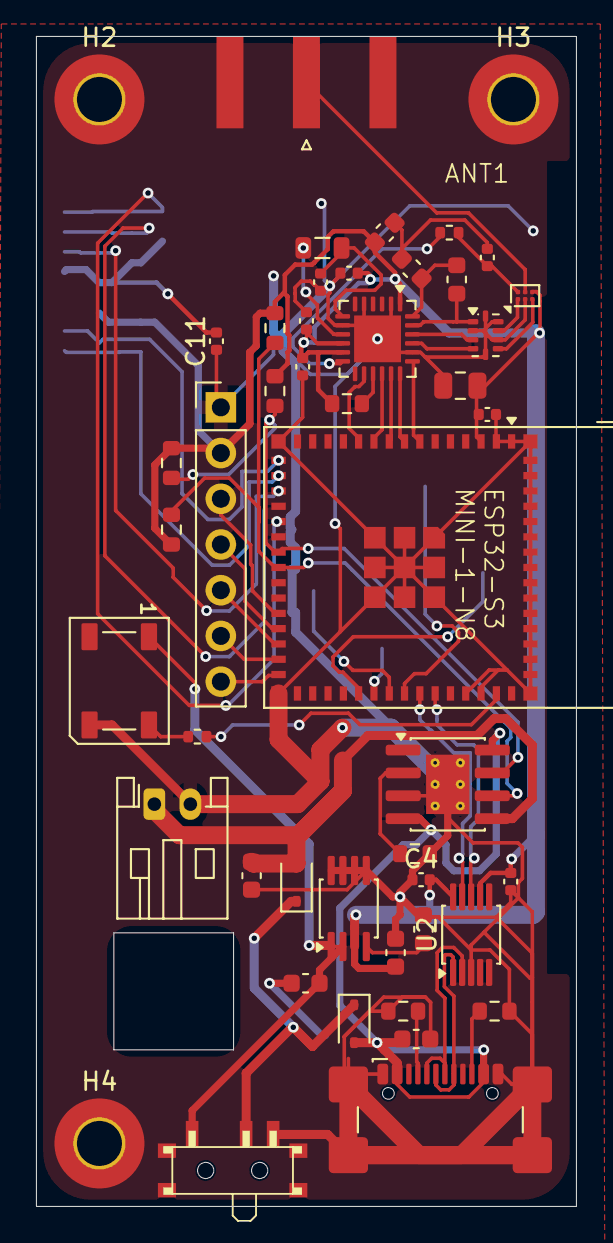
[picture p23: board KiCAD/main/finals/rev2.1/main.kicad_pcb from above]

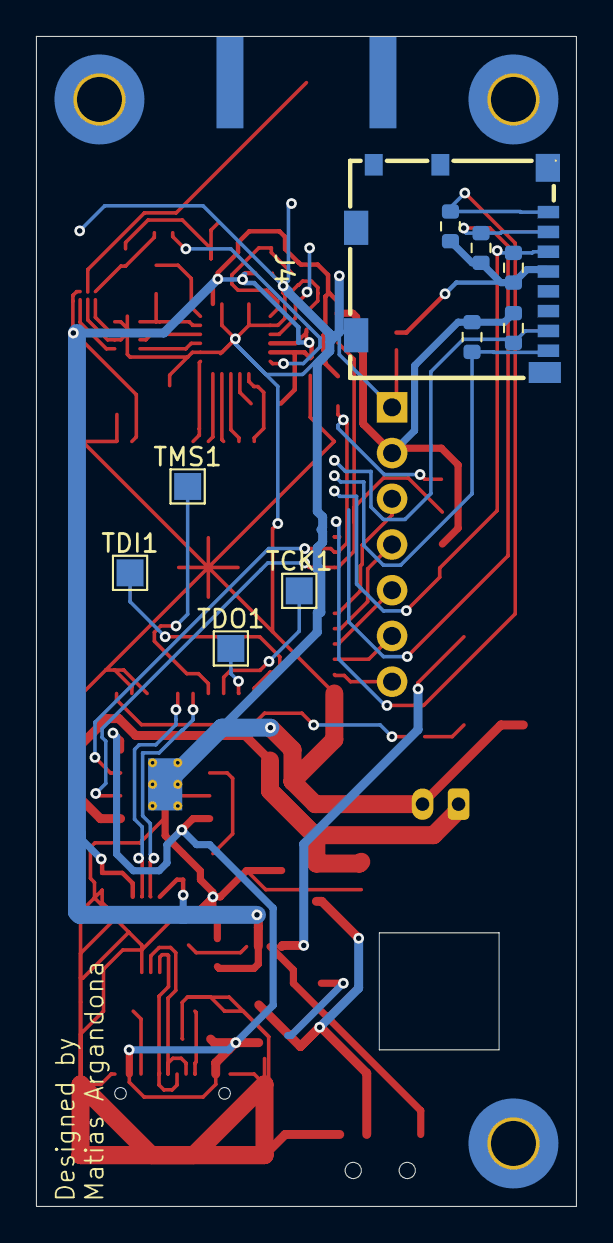
[picture p24: board KiCAD/main/finals/rev2.1/main.kicad_pcb from below]

Board: 2 copper layers, 30.0 x 65.0 mm, 57 parts (10 on the bottom side), 51 nets.

Other parts of the board:
R9#2, R10#2: 10K; R_0603_1608Metric

Their connections:
~CHRG: R10#2.1; also elsewhere on the board
~STDBY: R9#2.1; also elsewhere on the board
