matarga/vipr/KiCAD/main/finals/rev1.1/main.kicad_pcb

## KiCad design KiCAD/main/finals/rev1.1/main.kicad_pcb (2026-09-06, an earlier design)

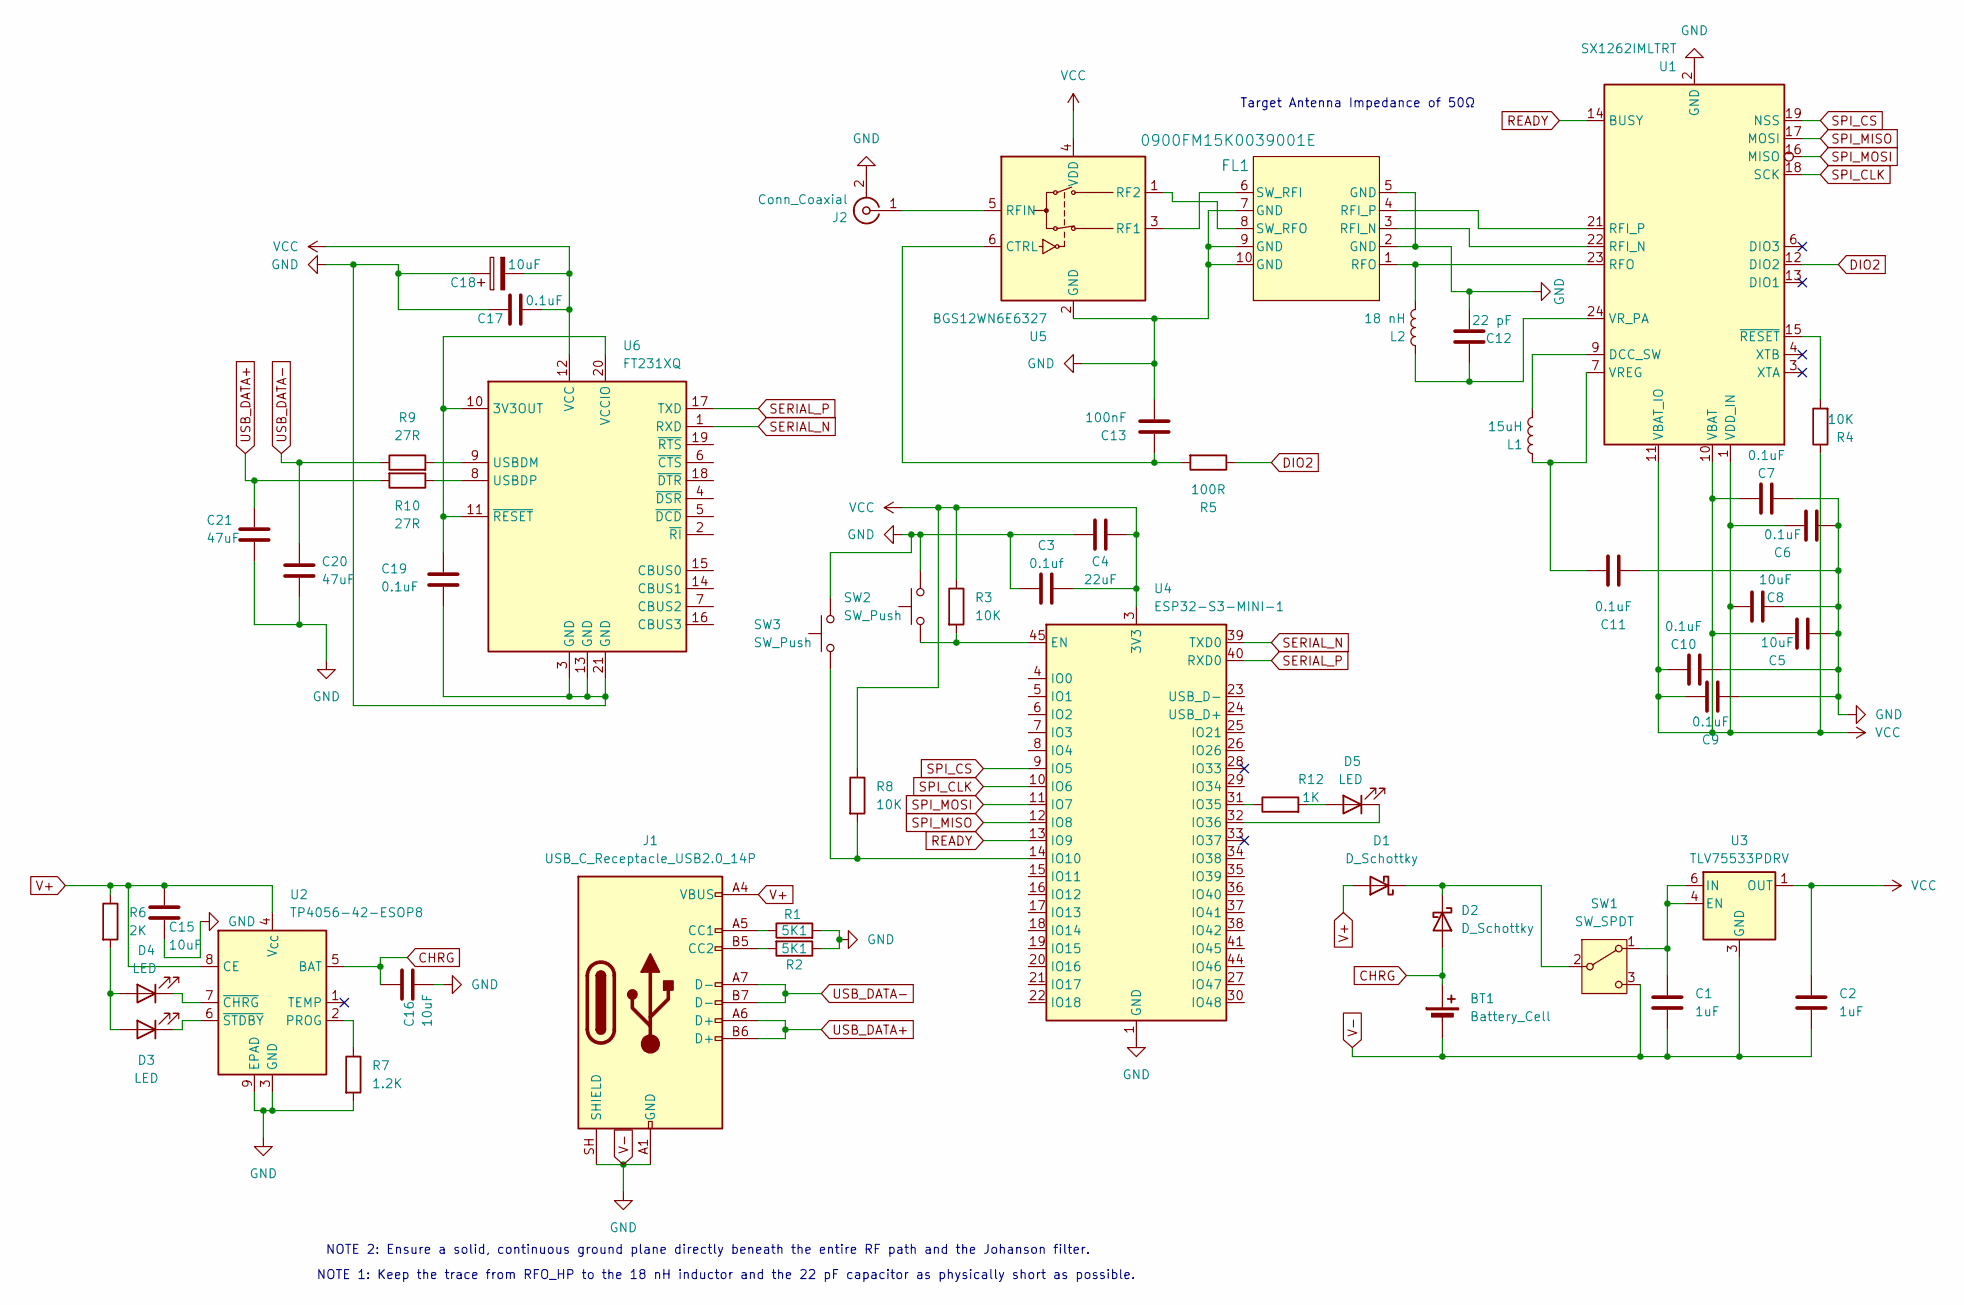
[picture p25: schematic main.kicad_sch]

Parts:
BT1: Battery_Cell; JST_PH_S2B-PH-K_1x02_P2.00mm_Horizontal
C1, C2: 1uF; C_01005_0402Metric
C3: 0.1uf; C_01005_0402Metric
C4: 22uF; C_01005_0402Metric
C5, C8, C15, C16: 10uF; C_01005_0402Metric
C6, C7, C9, C10, C11, C17, C19: 0.1uF; C_01005_0402Metric
C12: 22 pF; C_01005_0402Metric
C13: 100nF; C_01005_0402Metric
C18: 10uF; CP_EIA-1608-08_AVX-J
C20, C21: 47uF; C_01005_0402Metric
D1, D2: D_Schottky; D_01005_0402Metric
D3, D4, D5: LED; LED_0402_1005Metric
FL1: 0900FM15K0039001E; 0900FM15K0039001E_JOT-L
J1: USB_C_Receptacle_USB2.0_14P; USB_C_Receptacle_GCT_USB4110
J2: Conn_Coaxial; SMA_Amphenol_132289_EdgeMount
L1: 15uH; L_01005_0402Metric
L2: 18 nH; L_01005_0402Metric
R1, R2: 5K1; R_01005_0402Metric
R3, R4, R8: 10K; R_01005_0402Metric
R5: 100R; R_01005_0402Metric
R6: 2K; R_01005_0402Metric
R7: 1.2K; R_01005_0402Metric
R9, R10: 27R; R_01005_0402Metric
R12: 1K; R_01005_0402Metric
SW1: SW_SPDT; SW_SPDT_PCM12
SW2: SW_Push; SW_SPST_PTS810
SW3: SW_Push; SW_SPST_PTS645Sx43SMTR92
U1: SX1262IMLTRT; QFN-24-1EP_4x4mm_P0.5mm_EP2.6x2.6mm
U2: TP4056-42-ESOP8; SOIC-8-1EP_3.9x4.9mm_P1.27mm_EP2.41x3.3mm_ThermalVias
U3: TLV75533PDRV; WSON-6-1EP_2x2mm_P0.65mm_EP1x1.6mm
U4: ESP32-S3-MINI-1; ESP32-S2-MINI-1
U5: BGS12WN6E6327; Infineon_PG-TSNP-6-10_0.7x1.1mm_0.7x1.1mm_P0.4mm
U6: FT231XQ; QFN-20-1EP_4x4mm_P0.5mm_EP2.5x2.5mm

Connections:
CHRG: BT1.1 (+), C16.2, D2.2 (A), U2.5 (BAT)
DIO2: R5.1, U1.12 (DIO2)
unnamed: D1.1 (K), D2.1 (K), SW1.2 (B)
unnamed: D3.2 (A), D4.2 (A), R6.2
unnamed: D3.1 (K), U2.6 (~STDBY)
unnamed: D4.1 (K), U2.7 (~CHRG)
unnamed: D5.2 (A), R12.2
unnamed: D5.1 (K), U4.32 (IO36)
unnamed: FL1.3 (RFI_N), U1.22 (RFI_N)
unnamed: FL1.4 (RFI_P), U1.21 (RFI_P)
unnamed: FL1.1 (RFO), L2.2, U1.23 (RFO)
unnamed: FL1.6 (SW_RFI), U5.3 (RF1)
unnamed: FL1.8 (SW_RFO), U5.1 (RF2)
unnamed: J1.A5 (CC1), R1.1
unnamed: J1.B5 (CC2), R2.2
unnamed: J2.1 (In), U5.5 (RFIN)
unnamed: C1.2, SW1.1 (A), U3.4 (EN), U3.6 (IN)
unnamed: L1.2, U1.9 (DCC_SW)
unnamed: C11.2, L1.1, U1.7 (VREG)
unnamed: C12.1, L2.1, U1.24 (VR_PA)
unnamed: R4.2, U1.15 (~RESET)
unnamed: R7.1, U2.2 (PROG)
unnamed: R3.2, SW2.1, U4.45 (EN)
unnamed: R8.2, SW3.1, U4.14 (IO10)
unnamed: R12.1, U4.31 (IO35)
unnamed: C13.1, R5.2, U5.6 (CTRL)
unnamed: C19.2, U6.10 (3V3OUT), U6.11 (~RESET), U6.20 (VCCIO)
unnamed: R9.2, U6.9 (USBDM)
unnamed: R10.1, U6.8 (USBDP)
READY: U1.14 (BUSY), U4.13 (IO9)
SERIAL_N: U4.39 (TXD0), U6.1 (RXD)
SERIAL_P: U4.40 (RXD0), U6.17 (TXD)
SPI_CLK: U1.18 (SCK), U4.10 (IO6)
SPI_CS: U1.19 (NSS), U4.9 (IO5)
SPI_MISO: U1.17 (MOSI), U4.12 (IO8)
SPI_MOSI: U1.16 (MISO), U4.11 (IO7)
USB_DATA+: C21.1, J1.A6 (D+), J1.B6 (D+), R10.2
USB_DATA-: C20.1, J1.A7 (D-), J1.B7 (D-), R9.1
V+: C15.1, D1.2 (A), J1.A4 (VBUS), J1.A9 (VBUS), J1.B4 (VBUS), J1.B9 (VBUS), R6.1, U2.4 (V_{CC}), U2.8 (CE)
V-: BT1.2 (-), C1.1, C2.1, C3.1, C4.1, C5.2, C6.2, C7.2, C8.2, C9.2, C10.2, C11.1, C12.2, C13.2, C15.2, C16.1, C17.1, C18.1, C19.1, C20.2, C21.2, FL1.2 (GND), FL1.5 (GND), FL1.7 (GND), FL1.9 (GND), FL1.10 (GND), J1.A1 (GND), J1.A12 (GND), J1.B1 (GND), J1.B12 (GND), J1.SH (SHIELD), J2.2 (Ext), R1.2, R2.1, R7.2, SW1.3 (C), SW2.2, SW3.2, U1.2 (GND), U1.5 (GND), U1.8 (GND), U1.20 (GND), U1.25 (GND), U2.3 (GND), U2.9 (EPAD), U3.3 (GND), U3.7 (GND), U4.1 (GND), U4.2 (GND), U4.42 (GND), U4.43 (GND), U4.46 (GND), U4.47 (GND), U4.48 (GND), U4.49 (GND), U4.50 (GND), U4.51 (GND), U4.52 (GND), U4.53 (GND), U4.54 (GND), U4.55 (GND), U4.56 (GND), U4.57 (GND), U4.58 (GND), U4.59 (GND), U4.60 (GND), U4.61 (GND), U4.62 (GND), U4.63 (GND), U4.64 (GND), U4.65 (GND), U5.2 (GND), U6.3 (GND), U6.13 (GND), U6.21 (GND)
VCC: C2.2, C3.2, C4.2, C5.1, C6.1, C7.1, C8.1, C9.1, C10.1, C17.2, C18.2, R3.1, R4.1, R8.1, U1.1 (VDD_IN), U1.10 (VBAT), U1.11 (VBAT_IO), U3.1 (OUT), U4.3 (3V3), U5.4 (VDD), U6.12 (VCC)

Notes on the sheet:
NOTE 1: Keep the trace from RFO_HP to the 18 nH inductor and the 22 pF capacitor as physically short as possible.
NOTE 2: Ensure a solid, continuous ground plane directly beneath the entire RF path and the Johanson filter.
Target Antenna Impedance of 50Ω

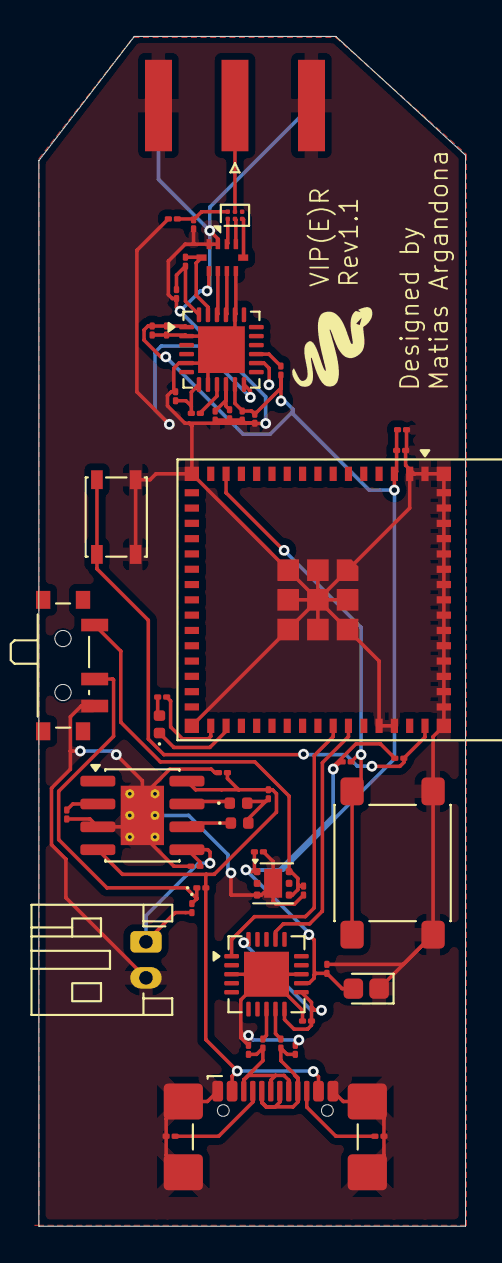
[picture p26: board KiCAD/main/finals/rev1.1/main.kicad_pcb from above]

Board: 2 copper layers, 23.7 x 66.1 mm, 51 parts (0 on the bottom side), 41 nets.
