matarga/vipr/(commit log)

2026-08-05 added a huge schematic overhaul
2026-10-18 Replaced ESP-WROOM module with ESP32-S3 module for flexable usage and stocking
